pepechorva/Rabosa/Images/Rabosa_pcb.png

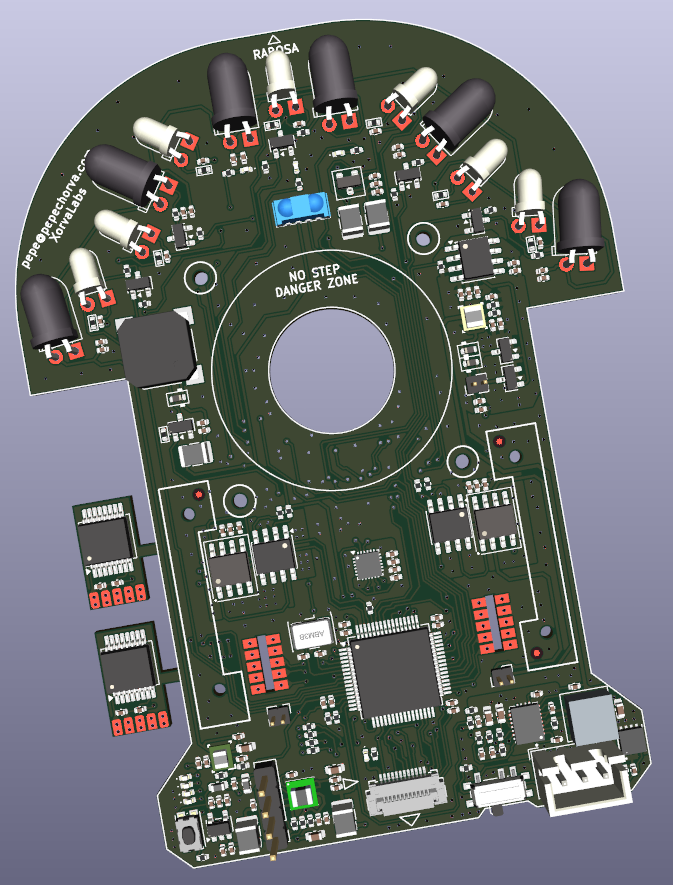
Images/Rabosa_pcb.png
