pepechorva/Rabosa/Hardware/KiCAD/Rabosa/IR_receiver.kicad_sch

## KiCad design Hardware/KiCAD/Rabosa/IR_receiver.kicad_sch (2025-11-17, last stored version)

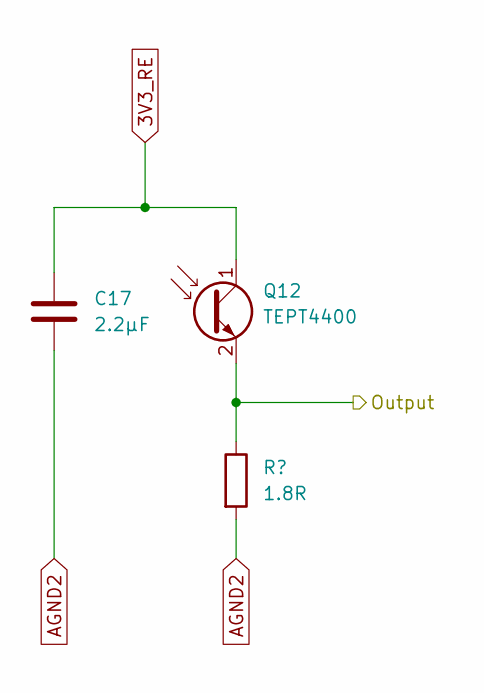
[picture p2: schematic IR_receiver.kicad_sch]

Parts:
C17: 2.2µF; C_0201_0603Metric
Q12: TEPT4400; LED_D3.0mm_Clear

Connections:
3V3_RE: C17.1, Q12.1 (C)
AGND2: C17.2
Output: Q12.2 (E)
