pepechorva/Rabosa/Hardware/KiCAD/Rabosa/Rabosa.kicad_sch

## KiCad design Hardware/KiCAD/Rabosa/Rabosa.kicad_sch (2025-11-17, last stored version)

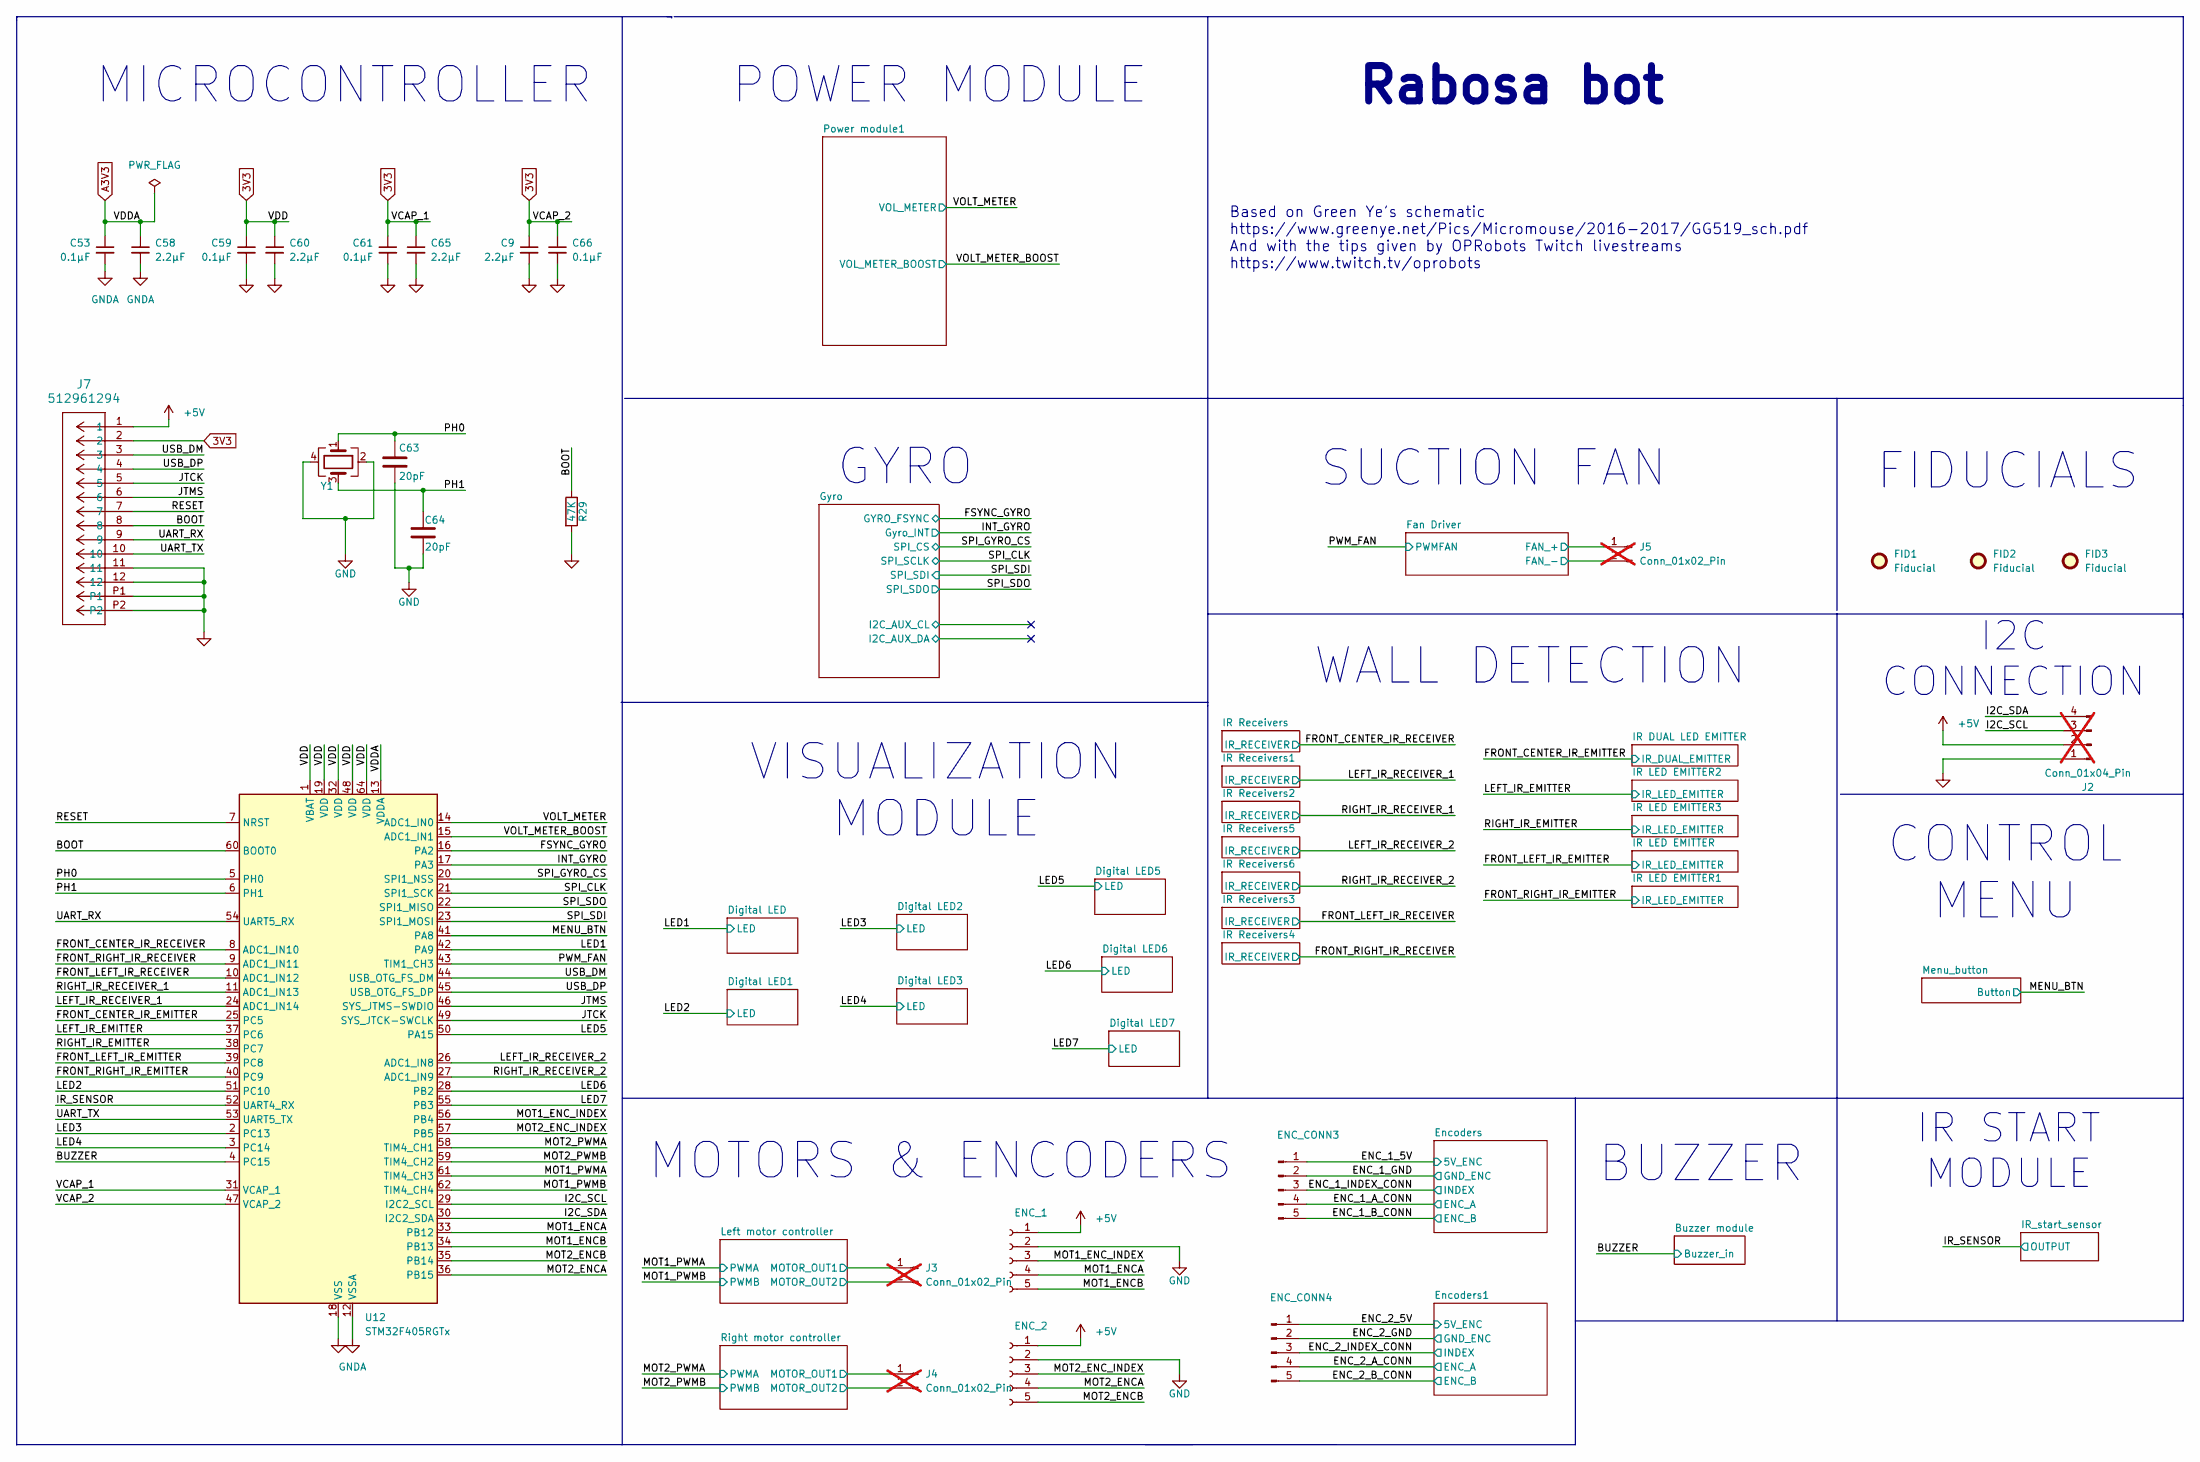
[picture p3: schematic Rabosa.kicad_sch]

Parts:
C9, C58, C60, C65: 2.2µF; C_0402_1005Metric; JLCPCB Part # C12530
C53, C59, C61, C66: 0.1µF; C_0402_1005Metric; JLCPCB Part # C1525
C63, C64: 20pF; C_0402_1005Metric; JLCPCB Part # C1554
ENC_1, ENC_2: Conn_01x05_Socket; Encoder_pcb; JLCPCB Part # NONE
ENC_CONN3, ENC_CONN4: Conn_01x05_Pin; encoder_conn; JLCPCB Part # NONE
FID1, FID2, FID3: Fiducial; Fiducial_0.75mm_Mask1.5mm; JLCPCB Part # NONE
J2: Conn_01x04_Pin; PinHeader_1x04_P2.54mm_Vertical; JLCPCB Part # C225256; not fitted
J3, J4, J5: Conn_01x02_Pin; PinHeader_1x02_P1.27mm_Vertical; JLCPCB Part # C131337; not fitted
J7: 512961294; CON_512961294_MOL; JLCPCB Part # C588127
R29: 47K; R_0402_1005Metric; JLCPCB Part # C25563
U12: STM32F405RGTx; LQFP-64_10x10mm_P0.5mm; JLCPCB Part # C94355
Y1: Crystal_GND24; Crystal_SMD_5032-4Pin_5.0x3.2mm; JLCPCB Part # C596873

Connections:
3V3: C9.1, C59.1, C60.1, C61.1, C65.1, C66.1, J7.2, U12.1 (VBAT), U12.19 (VDD), U12.31 (VCAP_1), U12.32 (VDD), U12.47 (VCAP_2), U12.48 (VDD), U12.64 (VDD)
+5V: ENC_1.1, ENC_2.1, J2.2, J7.1
A3V3: C53.1, C58.1, U12.13 (VDDA)
BOOT: J7.8, R29.1, U12.60 (BOOT0)
BUZZER: U12.4 (PC15)
ENC_1_5V: ENC_CONN3.1
ENC_1_A_CONN: ENC_CONN3.4
ENC_1_B_CONN: ENC_CONN3.5
ENC_1_GND: ENC_CONN3.2
ENC_1_INDEX_CONN: ENC_CONN3.3
ENC_2_5V: ENC_CONN4.1
ENC_2_A_CONN: ENC_CONN4.4
ENC_2_B_CONN: ENC_CONN4.5
ENC_2_GND: ENC_CONN4.2
ENC_2_INDEX_CONN: ENC_CONN4.3
FAN_+: J5.1
FAN_-: J5.2
FRONT_CENTER_IR_EMITTER: U12.25 (PC5)
FRONT_CENTER_IR_RECEIVER: U12.8 (PC0)
FRONT_LEFT_IR_EMITTER: U12.39 (PC8)
FRONT_LEFT_IR_RECEIVER: U12.10 (PC2)
FRONT_RIGHT_IR_EMITTER: U12.40 (PC9)
FRONT_RIGHT_IR_RECEIVER: U12.9 (PC1)
FSYNC_GYRO: U12.16 (PA2)
GND: C9.2, C59.2, C60.2, C61.2, C63.2, C64.2, C65.2, C66.2, ENC_1.2, ENC_2.2, J2.1, J7.11, J7.12, J7.P1, J7.P2, R29.2, U12.18 (VSS), U12.63 (VSS), Y1.2, Y1.4
GNDA: C53.2, C58.2, U12.12 (VSSA)
I2C_SCL: J2.3, U12.29 (PB10)
I2C_SDA: J2.4, U12.30 (PB11)
INT_GYRO: U12.17 (PA3)
IR_SENSOR: U12.52 (PC11)
JTCK: J7.5, U12.49 (PA14)
JTMS: J7.6, U12.46 (PA13)
LED1: U12.42 (PA9)
LED2: U12.51 (PC10)
LED3: U12.2 (PC13)
LED4: U12.3 (PC14)
LED5: U12.50 (PA15)
LED6: U12.28 (PB2)
LED7: U12.55 (PB3)
LEFT_IR_EMITTER: U12.37 (PC6)
LEFT_IR_RECEIVER_1: U12.24 (PC4)
LEFT_IR_RECEIVER_2: U12.26 (PB0)
MENU_BTN: U12.41 (PA8)
MOT1_ENCA: ENC_1.4, U12.33 (PB12)
MOT1_ENCB: ENC_1.5, U12.34 (PB13)
MOT1_ENC_INDEX: ENC_1.3, U12.56 (PB4)
MOT1_PWMA: U12.61 (PB8)
MOT1_PWMB: U12.62 (PB9)
MOT2_ENCA: ENC_2.4, U12.36 (PB15)
MOT2_ENCB: ENC_2.5, U12.35 (PB14)
MOT2_ENC_INDEX: ENC_2.3, U12.57 (PB5)
MOT2_PWMA: U12.58 (PB6)
MOT2_PWMB: U12.59 (PB7)
MOTOR_OUT1: J3.1, J4.1
MOTOR_OUT2: J3.2, J4.2
PH0: C63.1, U12.5 (PH0), Y1.1
PH1: C64.1, U12.6 (PH1), Y1.3
PWM_FAN: U12.43 (PA10)
RESET: J7.7, U12.7 (NRST)
RIGHT_IR_EMITTER: U12.38 (PC7)
RIGHT_IR_RECEIVER_1: U12.11 (PC3)
RIGHT_IR_RECEIVER_2: U12.27 (PB1)
SPI_CLK: U12.21 (PA5)
SPI_GYRO_CS: U12.20 (PA4)
SPI_SDI: U12.23 (PA7)
SPI_SDO: U12.22 (PA6)
UART_RX: J7.9, U12.54 (PD2)
UART_TX: J7.10, U12.53 (PC12)
USB_DM: J7.3, U12.44 (PA11)
USB_DP: J7.4, U12.45 (PA12)
VOLT_METER: U12.14 (PA0)
VOLT_METER_BOOST: U12.15 (PA1)

Notes on the sheet:
Rabosa bot
MICROCONTROLLER
GYRO
IR START MODULE
CONTROL MENU
FIDUCIALS
MOTORS & ENCODERS
WALL DETECTION
BUZZER
SUCTION FAN
POWER MODULE
Based on Green Ye's schematic https://www.greenye.net/Pics/Micromouse/2016-2017/GG519_sch.pdf And with the tips given by OPRobots Twitch livestreams https://www.twitch.tv/oprobots
I2C CONNECTION
VISUALIZATION MODULE
