pepechorva/Rabosa/Hardware/KiCAD/Rabosa/buzzer_module.kicad_sch

## KiCad design Hardware/KiCAD/Rabosa/buzzer_module.kicad_sch (2025-11-17, last stored version)

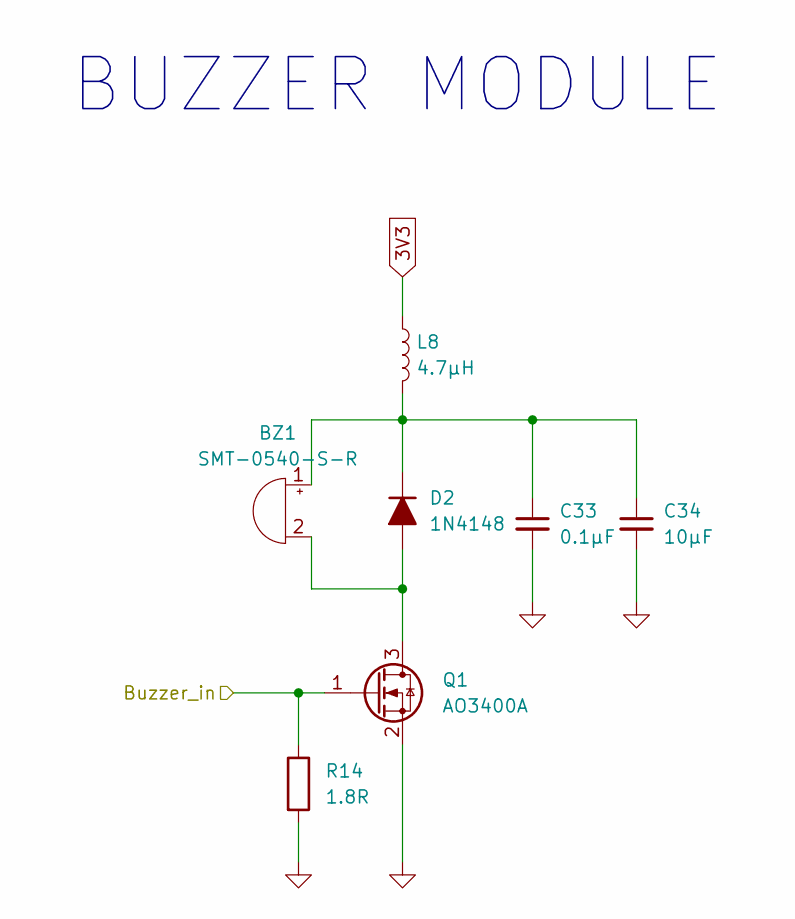
[picture p4: schematic buzzer_module.kicad_sch]

Parts:
BZ1: SMT-0540-S-R; MagneticBuzzer_Kobitone_254-EMB84Q-RO; JLCPCB Part # C3812104
C33: 0.1µF; C_0402_1005Metric; JLCPCB Part # C1525
C34: 10µF; C_0402_1005Metric; JLCPCB Part # C15525
D2: 1N4148; D_SOD-523; JLCPCB Part # C727112
L8: 4.7µH; L_1210_3225Metric; JLCPCB Part # C56767
Q1: AO3400A; SOT-23; JLCPCB Part # C20917
R14: 1.8R; R_0402_1005Metric; JLCPCB Part # C174229

Connections:
3V3: L8.1
Buzzer_in: Q1.1 (G), R14.1
GND: C33.2, C34.2, Q1.2 (S), R14.2
unnamed: BZ1.1 (+), C33.1, C34.1, D2.1 (K), L8.2
unnamed: BZ1.2 (-), D2.2 (A), Q1.3 (D)

Notes on the sheet:
BUZZER MODULE
