pepechorva/Rabosa/Hardware/KiCAD/Rabosa/digital_led.kicad_sch

## KiCad design Hardware/KiCAD/Rabosa/digital_led.kicad_sch (2025-11-17, last stored version)

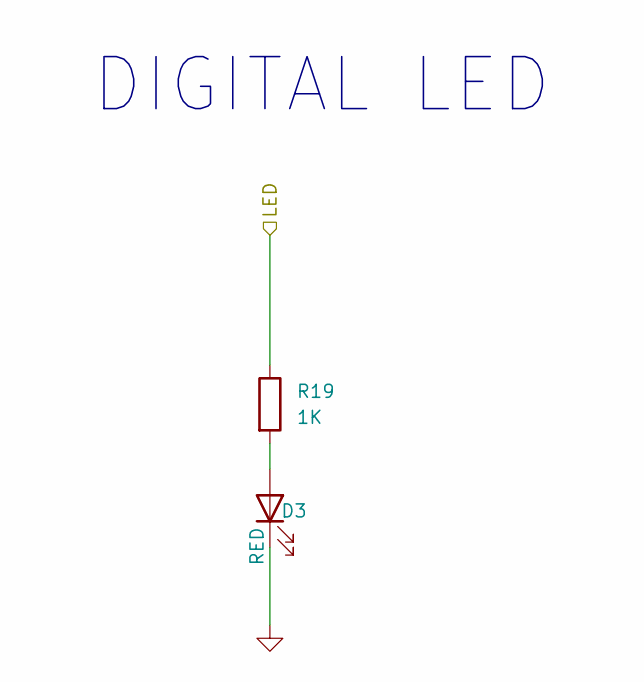
[picture p5: schematic digital_led.kicad_sch]

Parts:
D3: RED; LED_0402_1005Metric; JLCPCB Part # C71911
R19: 1K; R_0402_1005Metric; JLCPCB Part # C174151

Connections:
GND: D3.1 (K)
LED: R19.1
unnamed: D3.2 (A), R19.2

Notes on the sheet:
DIGITAL LED
