pepechorva/Rabosa/Hardware/KiCAD/Rabosa/double_IR_emitter.kicad_sch

## KiCad design Hardware/KiCAD/Rabosa/double_IR_emitter.kicad_sch (2025-11-17, last stored version)

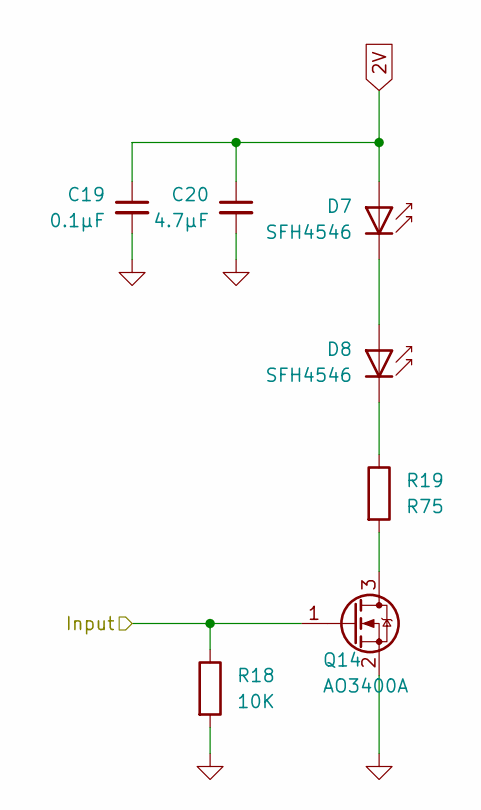
[picture p6: schematic double_IR_emitter.kicad_sch]

Parts:
C19: 0.1µF; C_0201_0603Metric
C20: 4.7µF; C_0201_0603Metric
D7, D8: SFH4546; LED_D5.0mm_IRGrey
Q14: AO3400A; SOT-23
R18: 10K; R_0201_0603Metric
R19: R75; R_0201_0603Metric

Connections:
2V: C19.1, C20.1, D7.2 (A)
GND: C19.2, C20.2, Q14.2 (S), R18.2
Input: Q14.1 (G), R18.1
unnamed: D7.1 (K), D8.2 (A)
unnamed: D8.1 (K), R19.1
unnamed: Q14.3 (D), R19.2
