pepechorva/Rabosa/Hardware/KiCAD/Rabosa/encoders.kicad_sch

## KiCad design Hardware/KiCAD/Rabosa/encoders.kicad_sch (2025-11-17, last stored version)

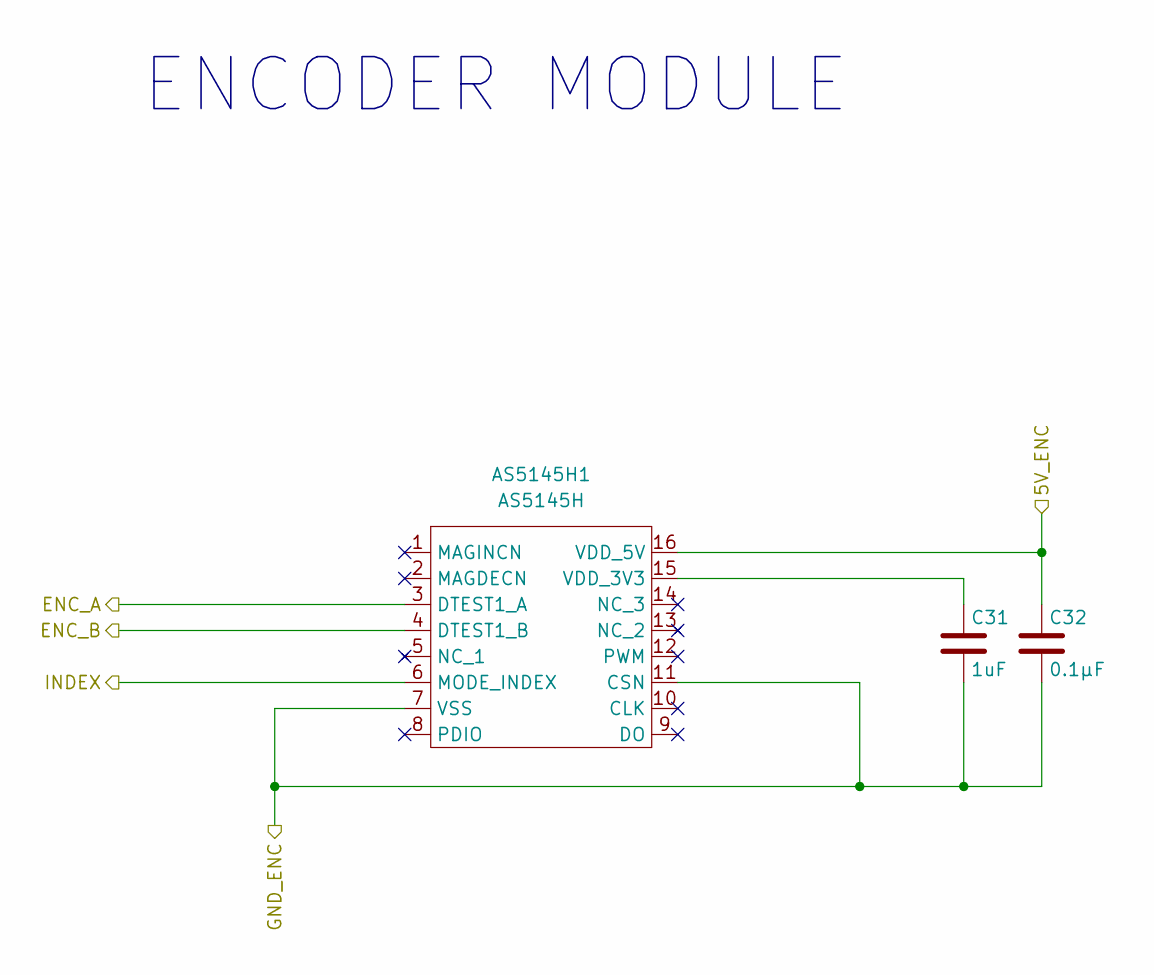
[picture p7: schematic encoders.kicad_sch]

Parts:
AS5145H1: AS5145H; SSOP-16_5.3x6.2mm_P0.65mm; JLCPCB Part # C481877
C31: 1uF; C_0402_1005Metric; JLCPCB Part # C14445
C32: 0.1µF; C_0402_1005Metric; JLCPCB Part # C1525

Connections:
5V_ENC: AS5145H1.16 (VDD_5V), C32.1
ENC_A: AS5145H1.3 (DTEST1_A)
ENC_B: AS5145H1.4 (DTEST1_B)
GND_ENC: AS5145H1.7 (VSS), AS5145H1.11 (CSN), C31.2, C32.2
INDEX: AS5145H1.6 (MODE_INDEX)
unnamed: AS5145H1.15 (VDD_3V3), C31.1

Notes on the sheet:
ENCODER MODULE
