pepechorva/Rabosa/Hardware/KiCAD/Rabosa/fan_driver.kicad_sch

## KiCad design Hardware/KiCAD/Rabosa/fan_driver.kicad_sch (2025-11-17, last stored version)

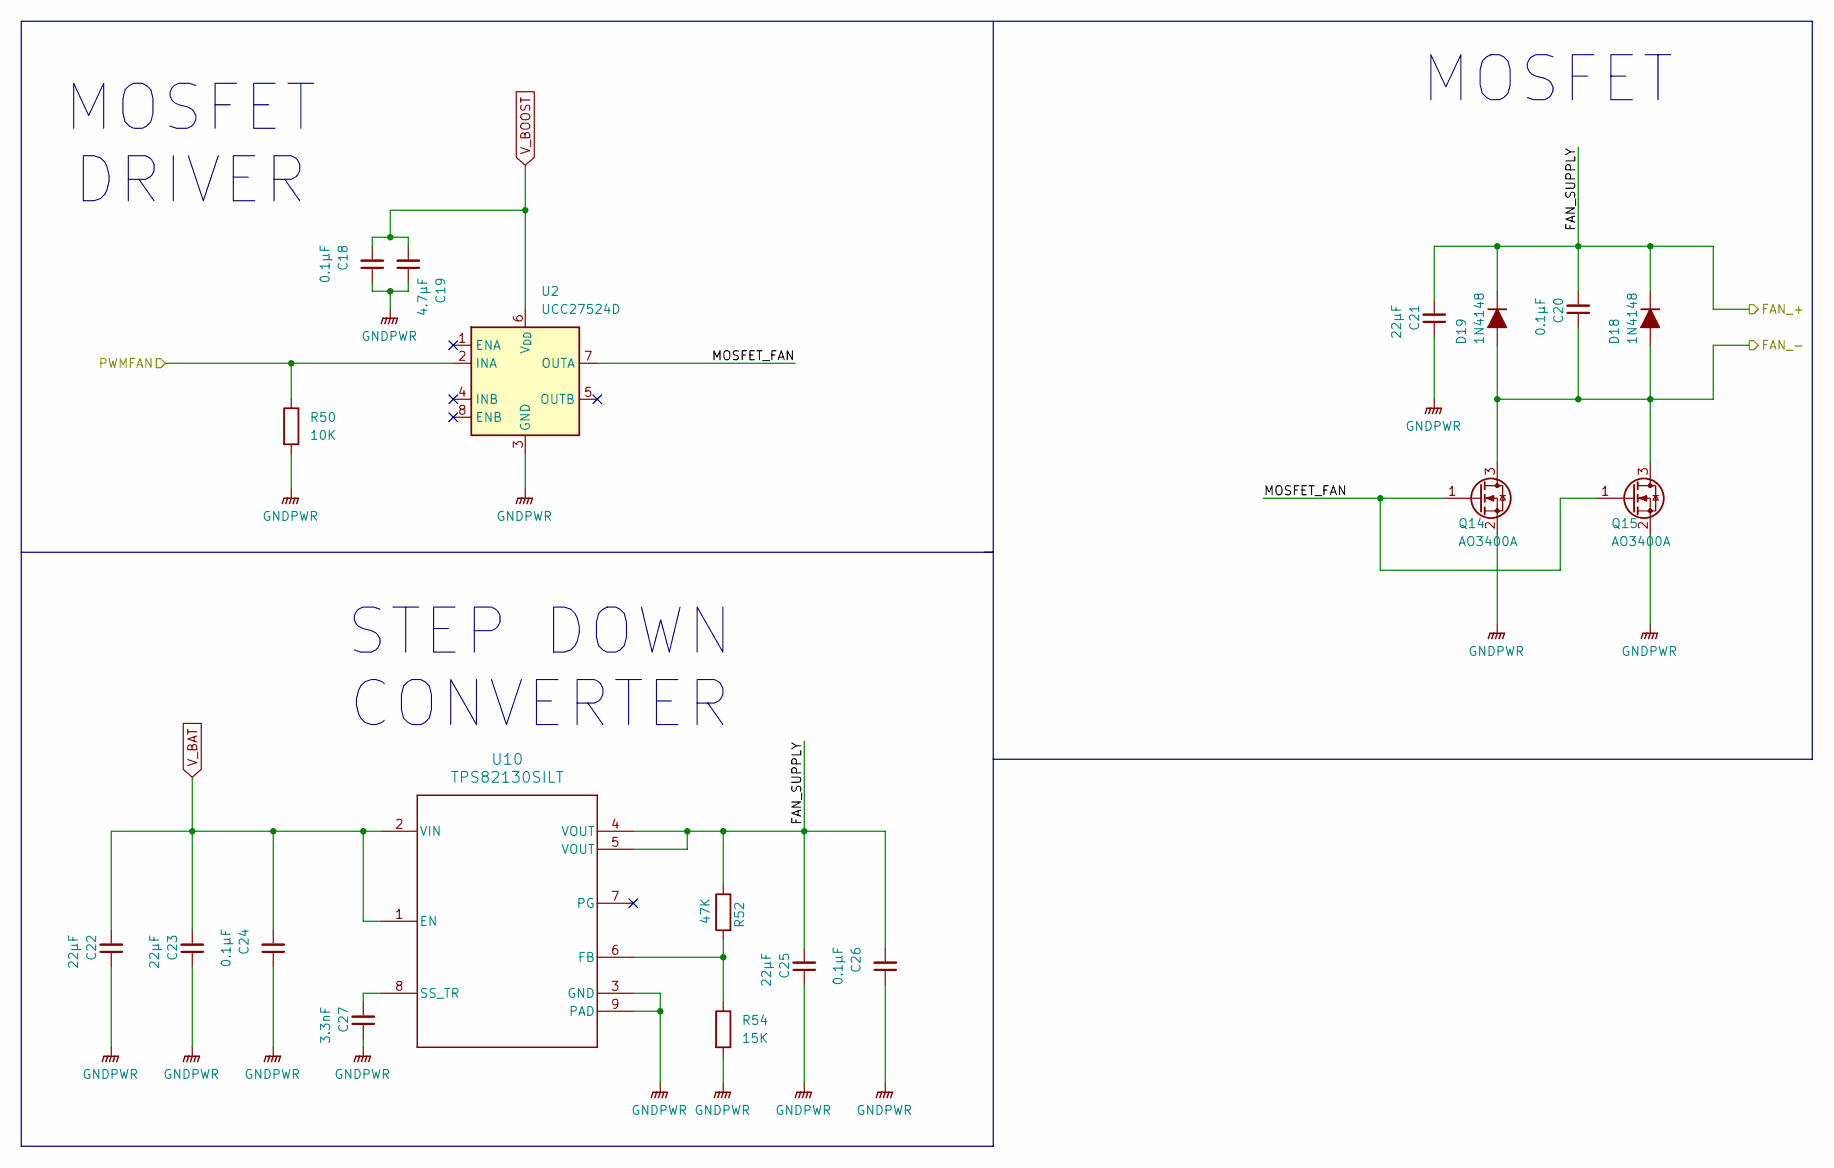
[picture p8: schematic fan_driver.kicad_sch]

Parts:
C18, C20, C24, C26: 0.1µF; C_0402_1005Metric; JLCPCB Part # C1525
C19: 4.7µF; C_0402_1005Metric; JLCPCB Part # C23687
C21, C22, C23, C25: 22µF; C_0402_1005Metric; JLCPCB Part # C105226
C27: 3.3nF; C_0402_1005Metric; JLCPCB Part # C1536
D18, D19: 1N4148; D_SOD-523; JLCPCB Part # C727112
Q14, Q15: AO3400A; SOT-23; JLCPCB Part # C20917
R50: 10K; R_0402_1005Metric; JLCPCB Part # C174175
R52: 47K; R_0402_1005Metric; JLCPCB Part # C25563
R54: 15K; R_0402_1005Metric; JLCPCB Part # C173692
U2: UCC27524D; SOIC-8_3.9x4.9mm_P1.27mm; JLCPCB Part # C5334499
U10: TPS82130SILT; JLCPCB Part # C163210

Connections:
FAN_+: C20.2, C21.2, C25.2, C26.2, D18.1 (K), D19.1 (K), R52.1, U10.4 (VOUT), U10.5 (VOUT)
FAN_-: C20.1, D18.2 (A), D19.2 (A), Q14.3 (D), Q15.3 (D)
GNDPWR: C18.1, C19.1, C21.1, C22.1, C23.1, C24.1, C25.1, C26.1, C27.1, Q14.2 (S), Q15.2 (S), R50.2, R54.2, U2.3 (GND), U10.3 (GND), U10.9 (PAD)
MOSFET_FAN: Q14.1 (G), Q15.1 (G), U2.7 (OUTA)
unnamed: C27.2, U10.8 (SS_TR)
unnamed: R52.2, R54.1, U10.6 (FB)
PWMFAN: R50.1, U2.2 (INA)
V_BAT: C22.2, C23.2, C24.2, U10.1 (EN), U10.2 (VIN)
V_BOOST: C18.2, C19.2, U2.6 (V_{DD})

Notes on the sheet:
MOSFET
STEP DOWN CONVERTER
MOSFET DRIVER
