pepechorva/Rabosa/Hardware/KiCAD/Rabosa/gyro.kicad_sch

## KiCad design Hardware/KiCAD/Rabosa/gyro.kicad_sch (2025-11-17, last stored version)

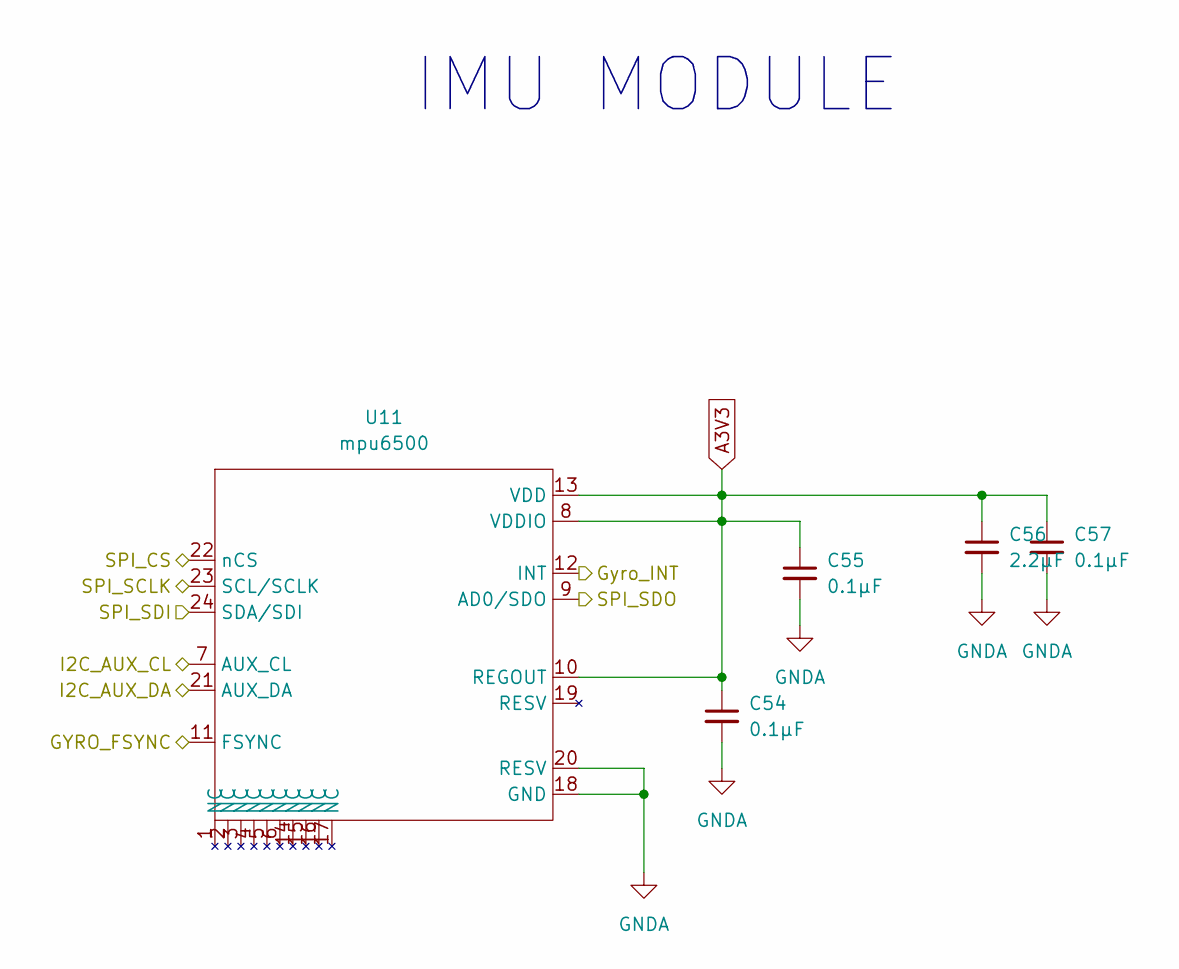
[picture p9: schematic gyro.kicad_sch]

Parts:
C54, C55, C57: 0.1µF; C_0402_1005Metric; JLCPCB Part # C1525
C56: 2.2µF; C_0402_1005Metric; JLCPCB Part # C12530
U11: mpu6500; InvenSense_QFN-24_3x3mm_P0.4mm; JLCPCB Part # C50278

Connections:
A3V3: C54.1, C55.1, C56.1, C57.1, U11.8 (VDDIO), U11.10 (REGOUT), U11.13 (VDD)
GNDA: C54.2, C55.2, C56.2, C57.2, U11.18 (GND), U11.20 (RESV)
GYRO_FSYNC: U11.11 (FSYNC)
Gyro_INT: U11.12 (INT)
I2C_AUX_CL: U11.7 (AUX_CL)
I2C_AUX_DA: U11.21 (AUX_DA)
SPI_CS: U11.22 (nCS)
SPI_SCLK: U11.23 (SCL/SCLK)
SPI_SDI: U11.24 (SDA/SDI)
SPI_SDO: U11.9 (AD0/SDO)

Notes on the sheet:
IMU MODULE
