pepechorva/Rabosa/Hardware/KiCAD/Rabosa/ir_dual_led_emitter.kicad_sch

## KiCad design Hardware/KiCAD/Rabosa/ir_dual_led_emitter.kicad_sch (2025-11-17, last stored version)

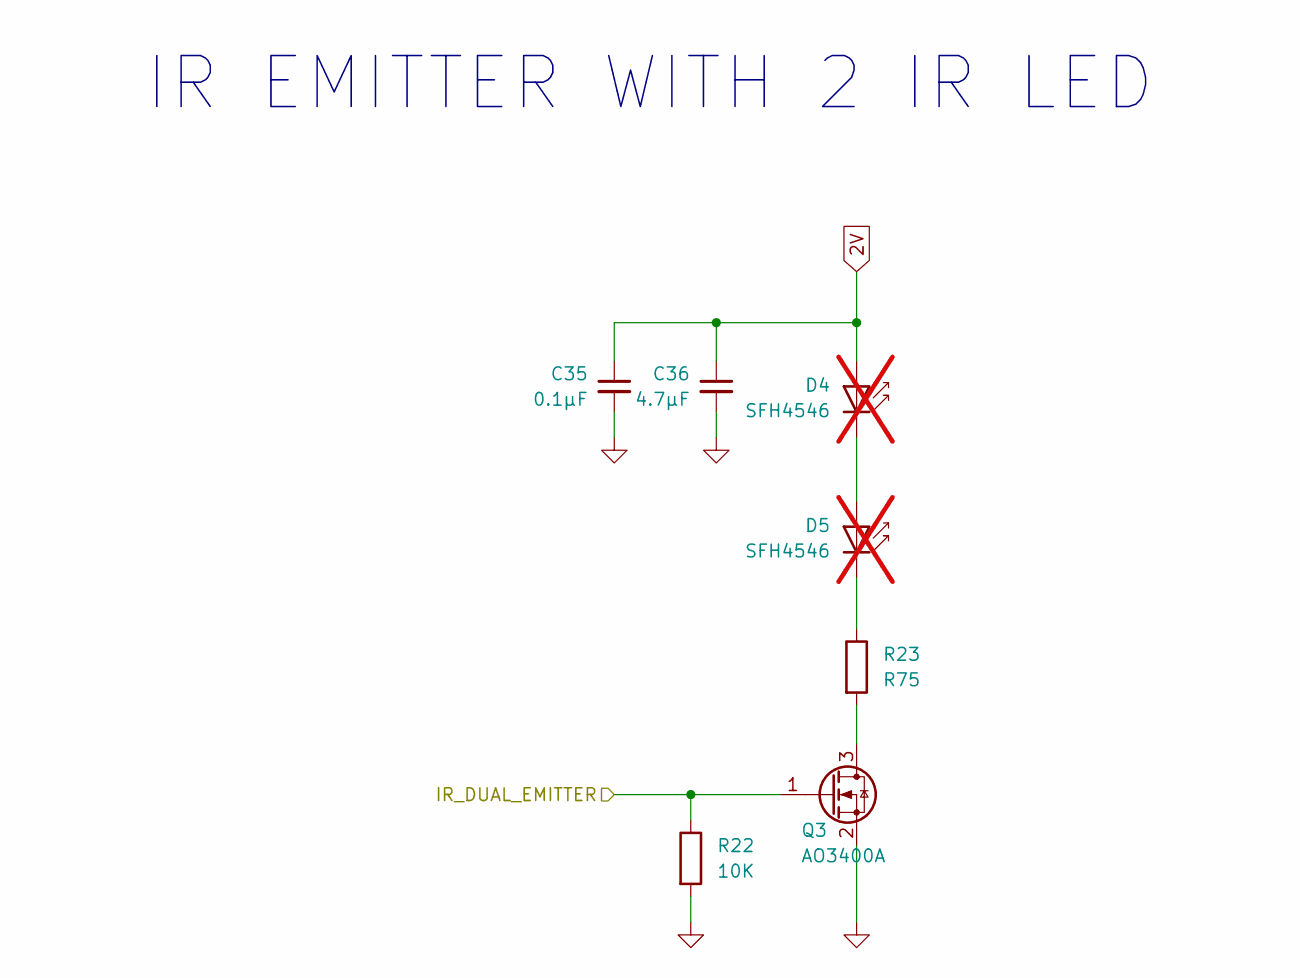
[picture p10: schematic ir_dual_led_emitter.kicad_sch]

Parts:
C35: 0.1µF; C_0402_1005Metric; JLCPCB Part # C1525
C36: 4.7µF; C_0402_1005Metric; JLCPCB Part # C23687
D4, D5: SFH4546; LED_D5.0mm_Horizontal_O1.27mm_Z3.0mm_IRGrey; JLCPCB Part # C2900373; not fitted
Q3: AO3400A; SOT-23; JLCPCB Part # C20917
R22: 10K; R_0402_1005Metric; JLCPCB Part # C174175
R23: R75; R_0402_1005Metric; JLCPCB Part # C22369159

Connections:
2V: C35.1, C36.1, D4.2 (A)
GND: C35.2, C36.2, Q3.2 (S), R22.2
IR_DUAL_EMITTER: Q3.1 (G), R22.1
unnamed: D4.1 (K), D5.2 (A)
unnamed: D5.1 (K), R23.1
unnamed: Q3.3 (D), R23.2

Notes on the sheet:
IR EMITTER WITH 2 IR LED
