pepechorva/Rabosa/Hardware/KiCAD/Rabosa/ir_emitter.kicad_sch

## KiCad design Hardware/KiCAD/Rabosa/ir_emitter.kicad_sch (2025-11-17, last stored version)

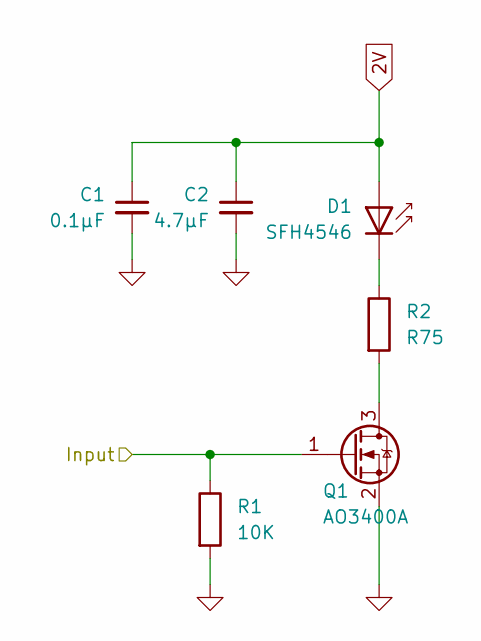
[picture p11: schematic ir_emitter.kicad_sch]

Parts:
C1: 0.1µF; C_0201_0603Metric
C2: 4.7µF; C_0201_0603Metric
D1: SFH4546; LED_D5.0mm_IRGrey
Q1: AO3400A; SOT-23
R1: 10K; R_0201_0603Metric
R2: R75; R_0201_0603Metric

Connections:
2V: C1.1, C2.1, D1.2 (A)
GND: C1.2, C2.2, Q1.2 (S), R1.2
Input: Q1.1 (G), R1.1
unnamed: D1.1 (K), R2.1
unnamed: Q1.3 (D), R2.2
