pepechorva/Rabosa/Hardware/KiCAD/Rabosa/ir_led_emitter.kicad_sch

## KiCad design Hardware/KiCAD/Rabosa/ir_led_emitter.kicad_sch (2025-11-17, last stored version)

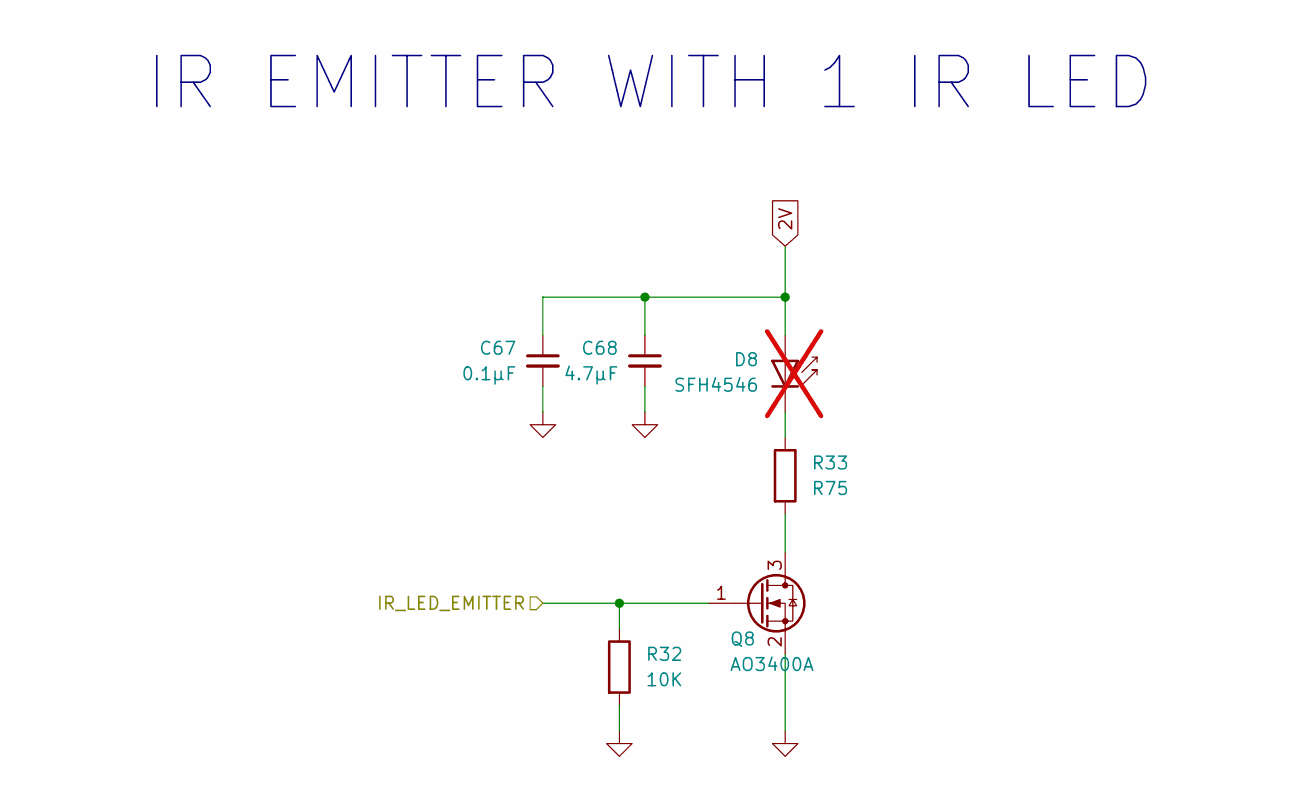
[picture p12: schematic ir_led_emitter.kicad_sch]

Parts:
C67: 0.1µF; C_0402_1005Metric; JLCPCB Part # C1525
C68: 4.7µF; C_0402_1005Metric; JLCPCB Part # C23687
D8: SFH4546; LED_D5.0mm_Horizontal_O1.27mm_Z3.0mm_IRGrey; JLCPCB Part # C2900373; not fitted
Q8: AO3400A; SOT-23; JLCPCB Part # C20917
R32: 10K; R_0402_1005Metric; JLCPCB Part # C174175
R33: R75; R_0402_1005Metric; JLCPCB Part # C22369159

Connections:
2V: C67.1, C68.1, D8.2 (A)
GND: C67.2, C68.2, Q8.2 (S), R32.2
IR_LED_EMITTER: Q8.1 (G), R32.1
unnamed: D8.1 (K), R33.1
unnamed: Q8.3 (D), R33.2

Notes on the sheet:
IR EMITTER WITH 1 IR LED
