pepechorva/Rabosa/Hardware/KiCAD/Rabosa/ir_receiver.kicad_sch

## KiCad design Hardware/KiCAD/Rabosa/ir_receiver.kicad_sch (2025-11-17, last stored version)

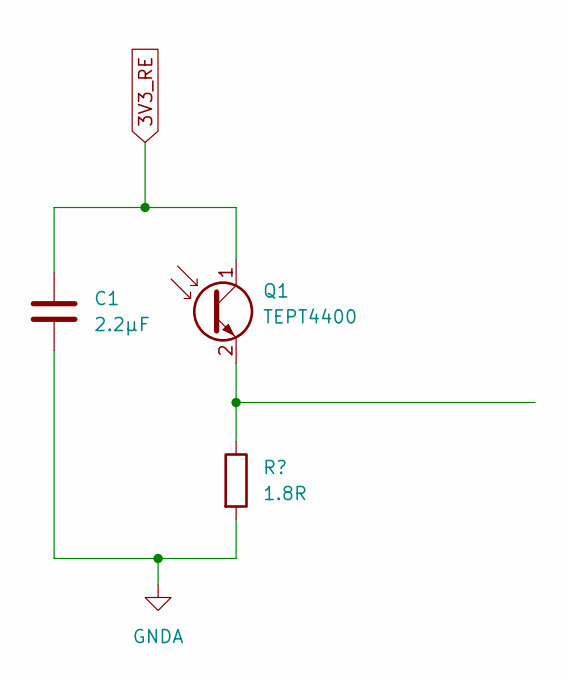
[picture p13: schematic ir_receiver.kicad_sch]

Parts:
C1: 2.2µF; C_0201_0603Metric
Q1: TEPT4400; LED_D3.0mm_Clear

Connections:
3V3_RE: C1.1, Q1.1 (C)
GNDA: C1.2
