pepechorva/Rabosa/Hardware/KiCAD/Rabosa/ir_receivers.kicad_sch

## KiCad design Hardware/KiCAD/Rabosa/ir_receivers.kicad_sch (2025-11-17, last stored version)

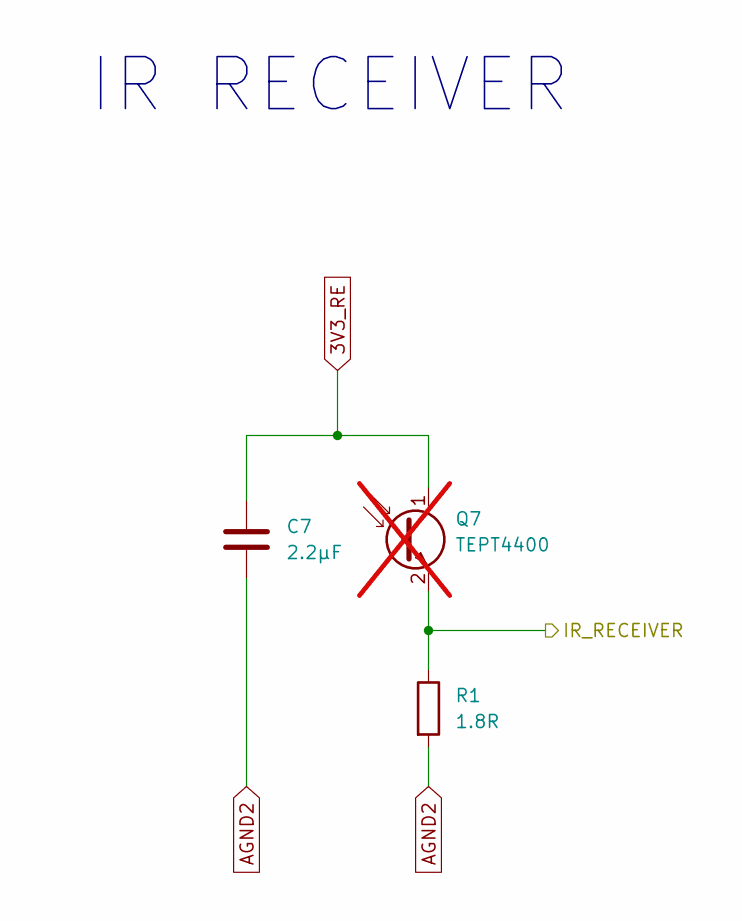
[picture p14: schematic ir_receivers.kicad_sch]

Parts:
C7: 2.2µF; C_0402_1005Metric; JLCPCB Part # C12530
Q7: TEPT4400; LED_D3.0mm_Horizontal_O1.27mm_Z2.0mm_Clear; JLCPCB Part # C132178; not fitted
R1: 1.8R; R_0402_1005Metric; JLCPCB Part # C174229

Connections:
3V3_RE: C7.1, Q7.1 (C)
AGND2: C7.2, R1.2
IR_RECEIVER: Q7.2 (E), R1.1

Notes on the sheet:
IR RECEIVER
