pepechorva/Rabosa/Hardware/KiCAD/Rabosa/microcontroller.kicad_sch

## KiCad design Hardware/KiCAD/Rabosa/microcontroller.kicad_sch (2025-11-17, last stored version)

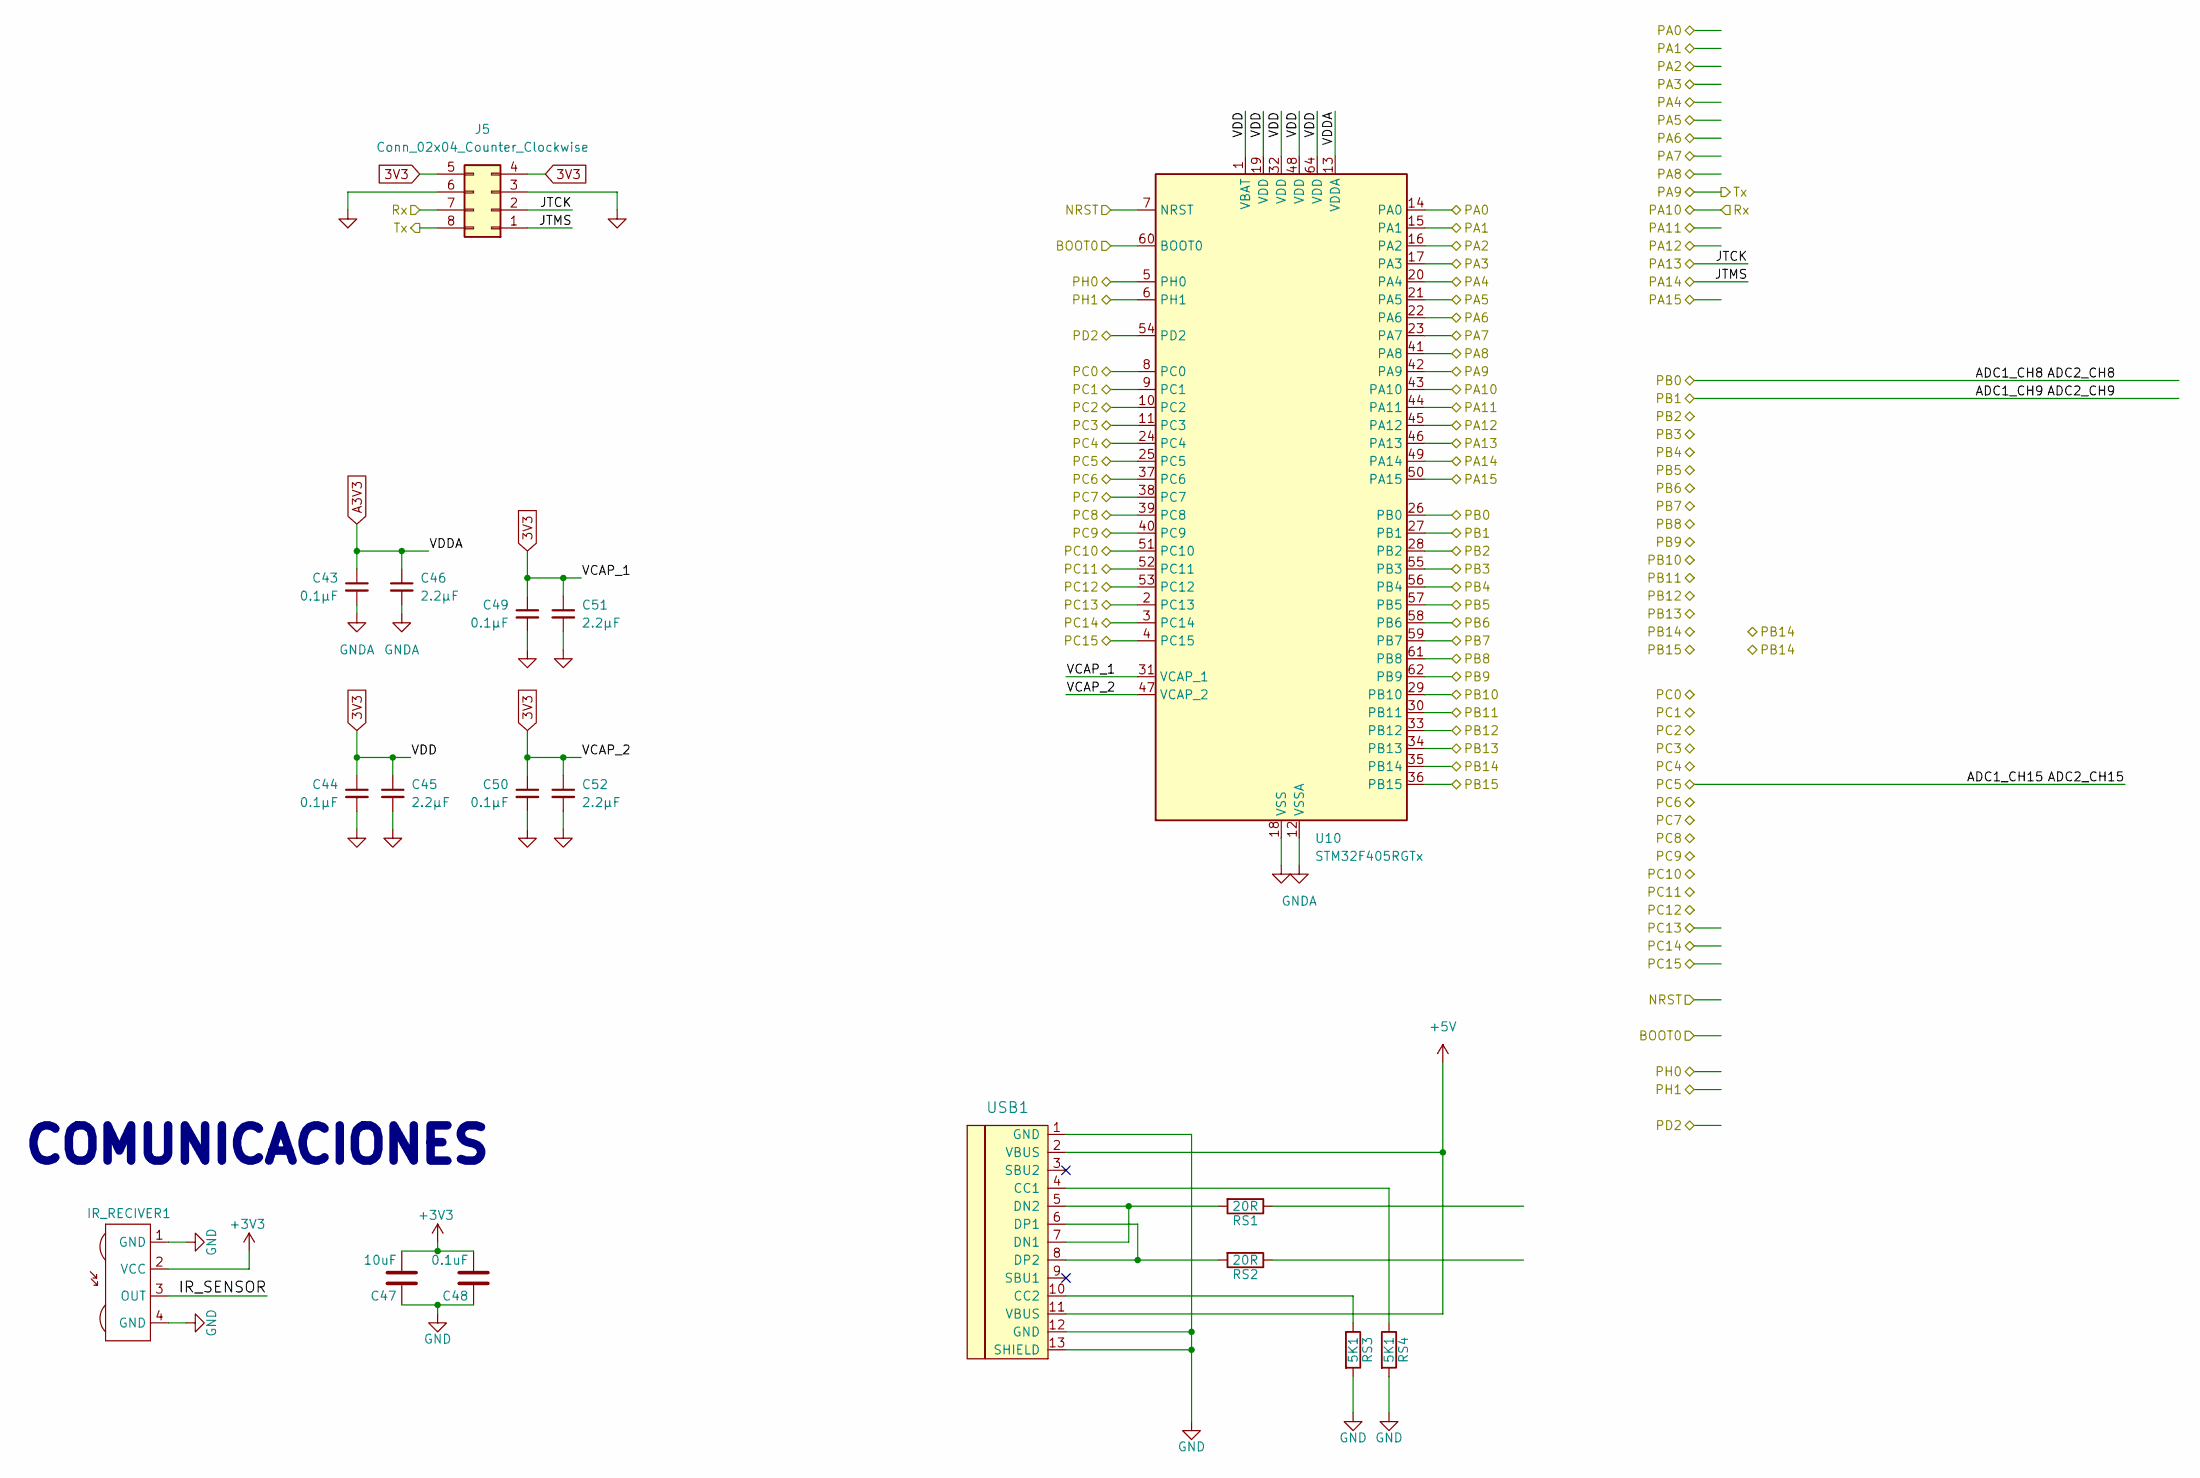
[picture p15: schematic microcontroller.kicad_sch]

Parts:
C43, C44, C49, C50: 0.1µF; C_0201_0603Metric
C45, C46, C51, C52: 2.2µF; C_0201_0603Metric
C47: 10uF; C_0402_1005Metric_Pad0.74x0.62mm_HandSolder
C48: 0.1uF; C_0402_1005Metric_Pad0.74x0.62mm_HandSolder
IR_RECIVER1: IR_SENSOR_SMD_TSSP77038ETR
J5: Conn_02x04_Counter_Clockwise; PinHeader_2x04_P2.54mm_Vertical
RS1, RS2: 20R; R_0805_2012Metric_Pad1.20x1.40mm_HandSolder
RS3, RS4: 5K1; R_0805_2012Metric_Pad1.20x1.40mm_HandSolder
U10: STM32F405RGTx; LQFP-64_10x10mm_P0.5mm
USB1: USB_C_Receptacle_GCT_USB4105-xx-A_16P_TopMnt_Horizontal

Connections:
3V3: C44.1, C45.1, C49.1, C50.1, C51.1, C52.1, J5.4, J5.5, U10.1 (VBAT), U10.19 (VDD), U10.31 (VCAP_1), U10.32 (VDD), U10.47 (VCAP_2), U10.48 (VDD), U10.64 (VDD)
+3V3: C47.2, C48.2, IR_RECIVER1.2 (VCC)
+5V: USB1.2 (VBUS), USB1.11 (VBUS)
A3V3: C43.1, C46.1, U10.13 (VDDA)
ADC1_CH8: U10.26 (PB0)
ADC1_CH9: U10.27 (PB1)
ADC1_CH15: U10.25 (PC5)
BOOT0: U10.60 (BOOT0)
GND: C44.2, C45.2, C47.1, C48.1, C49.2, C50.2, C51.2, C52.2, IR_RECIVER1.1 (GND), IR_RECIVER1.4 (GND), J5.3, J5.6, RS3.2, RS4.2, U10.18 (VSS), U10.63 (VSS), USB1.1 (GND), USB1.12 (GND), USB1.13 (SHIELD)
GNDA: C43.2, C46.2, U10.12 (VSSA)
IR_SENSOR: IR_RECIVER1.3 (OUT)
JTCK: J5.2, U10.46 (PA13)
JTMS: J5.1, U10.49 (PA14)
NRST: U10.7 (NRST)
unnamed: RS1.2, USB1.5 (DN2), USB1.7 (DN1)
unnamed: RS2.2, USB1.6 (DP1), USB1.8 (DP2)
unnamed: RS3.1, USB1.10 (CC2)
unnamed: RS4.1, USB1.4 (CC1)
PA0: U10.14 (PA0)
PA1: U10.15 (PA1)
PA2: U10.16 (PA2)
PA3: U10.17 (PA3)
PA4: U10.20 (PA4)
PA5: U10.21 (PA5)
PA6: U10.22 (PA6)
PA7: U10.23 (PA7)
PA8: U10.41 (PA8)
PA9: J5.8, U10.42 (PA9)
PA10: J5.7, U10.43 (PA10)
PA11: U10.44 (PA11)
PA12: U10.45 (PA12)
PA15: U10.50 (PA15)
PB2: U10.28 (PB2)
PB3: U10.55 (PB3)
PB4: U10.56 (PB4)
PB5: U10.57 (PB5)
PB6: U10.58 (PB6)
PB7: U10.59 (PB7)
PB8: U10.61 (PB8)
PB9: U10.62 (PB9)
PB10: U10.29 (PB10)
PB11: U10.30 (PB11)
PB12: U10.33 (PB12)
PB13: U10.34 (PB13)
PB14: U10.35 (PB14)
PB15: U10.36 (PB15)
PC0: U10.8 (PC0)
PC1: U10.9 (PC1)
PC2: U10.10 (PC2)
PC3: U10.11 (PC3)
PC4: U10.24 (PC4)
PC6: U10.37 (PC6)
PC7: U10.38 (PC7)
PC8: U10.39 (PC8)
PC9: U10.40 (PC9)
PC10: U10.51 (PC10)
PC11: U10.52 (PC11)
PC12: U10.53 (PC12)
PC13: U10.2 (PC13)
PC14: U10.3 (PC14)
PC15: U10.4 (PC15)
PD2: U10.54 (PD2)
PH0: U10.5 (PH0)
PH1: U10.6 (PH1)

Notes on the sheet:
COMUNICACIONES
