pepechorva/Rabosa/Hardware/KiCAD/Rabosa/motor_controller.kicad_sch

## KiCad design Hardware/KiCAD/Rabosa/motor_controller.kicad_sch (2025-11-17, last stored version)

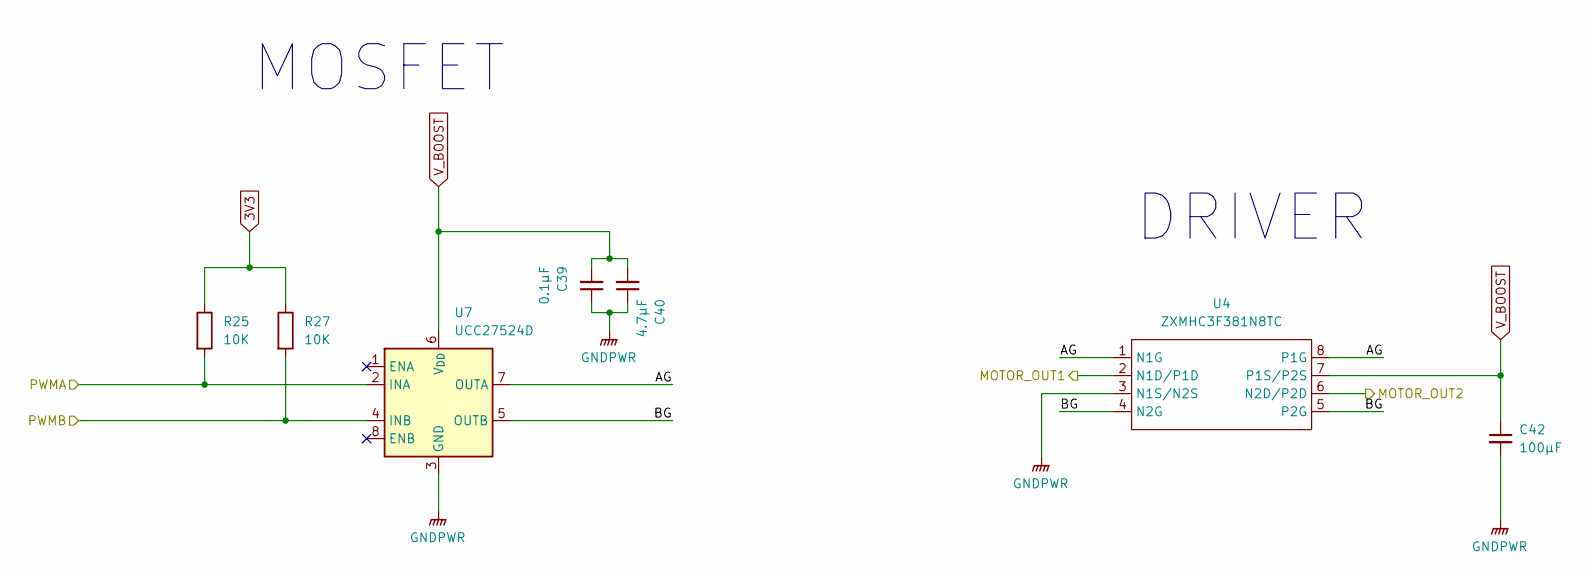
[picture p16: schematic motor_controller.kicad_sch]

Parts:
C39: 0.1µF; C_0402_1005Metric; JLCPCB Part # C1525
C40: 4.7µF; C_0402_1005Metric; JLCPCB Part # C23687
C42: 100µF; C_0402_1005Metric; JLCPCB Part # C1959836
R25, R27: 10K; R_0402_1005Metric; JLCPCB Part # C174175
U4: ZXMHC3F381N8TC; SOIC-8_3.9x4.9mm_P1.27mm; JLCPCB Part # C87356
U7: UCC27524D; SOIC-8_3.9x4.9mm_P1.27mm; JLCPCB Part # C5334499

Connections:
3V3: R25.1, R27.1
AG: U4.1 (N1G), U4.8 (P1G), U7.7 (OUTA)
BG: U4.4 (N2G), U4.5 (P2G), U7.5 (OUTB)
GNDPWR: C39.1, C40.1, C42.2, U4.3 (N1S/N2S), U7.3 (GND)
MOTOR_OUT1: U4.2 (N1D/P1D)
MOTOR_OUT2: U4.6 (N2D/P2D)
PWMA: R25.2, U7.2 (INA)
PWMB: R27.2, U7.4 (INB)
V_BOOST: C39.2, C40.2, C42.1, U4.7 (P1S/P2S), U7.6 (V_{DD})

Notes on the sheet:
MOSFET
DRIVER
