pepechorva/Rabosa/Hardware/KiCAD/Rabosa/plugable_led.kicad_sch

## KiCad design Hardware/KiCAD/Rabosa/plugable_led.kicad_sch (2025-11-17, last stored version)

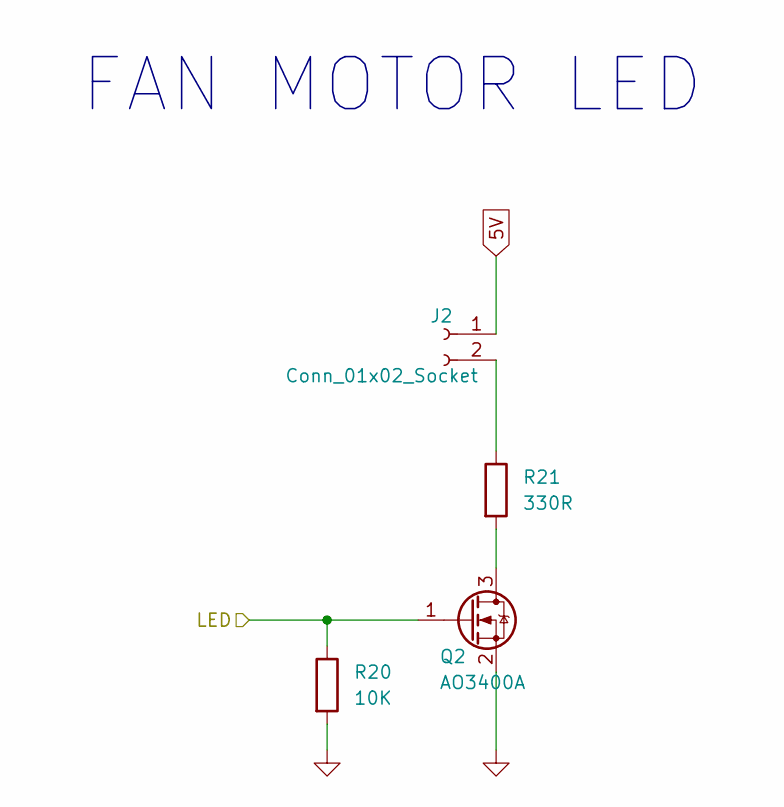
[picture p17: schematic plugable_led.kicad_sch]

Parts:
J2: Conn_01x02_Socket; PinSocket_1x02_P2.54mm_Vertical
Q2: AO3400A; SOT-23; JLCPCB Part # C20917
R20: 10K; R_0201_0603Metric; JLCPCB Part # C174175
R21: 330R; R_0201_0603Metric; JLCPCB Part # C177341

Connections:
5V: J2.1
GND: Q2.2 (S), R20.2
LED: Q2.1 (G), R20.1
unnamed: J2.2, R21.1
unnamed: Q2.3 (D), R21.2

Notes on the sheet:
FAN MOTOR LED
