pepechorva/Rabosa/Hardware/KiCAD/Rabosa/power_module.kicad_sch

## KiCad design Hardware/KiCAD/Rabosa/power_module.kicad_sch (2025-11-17, last stored version)

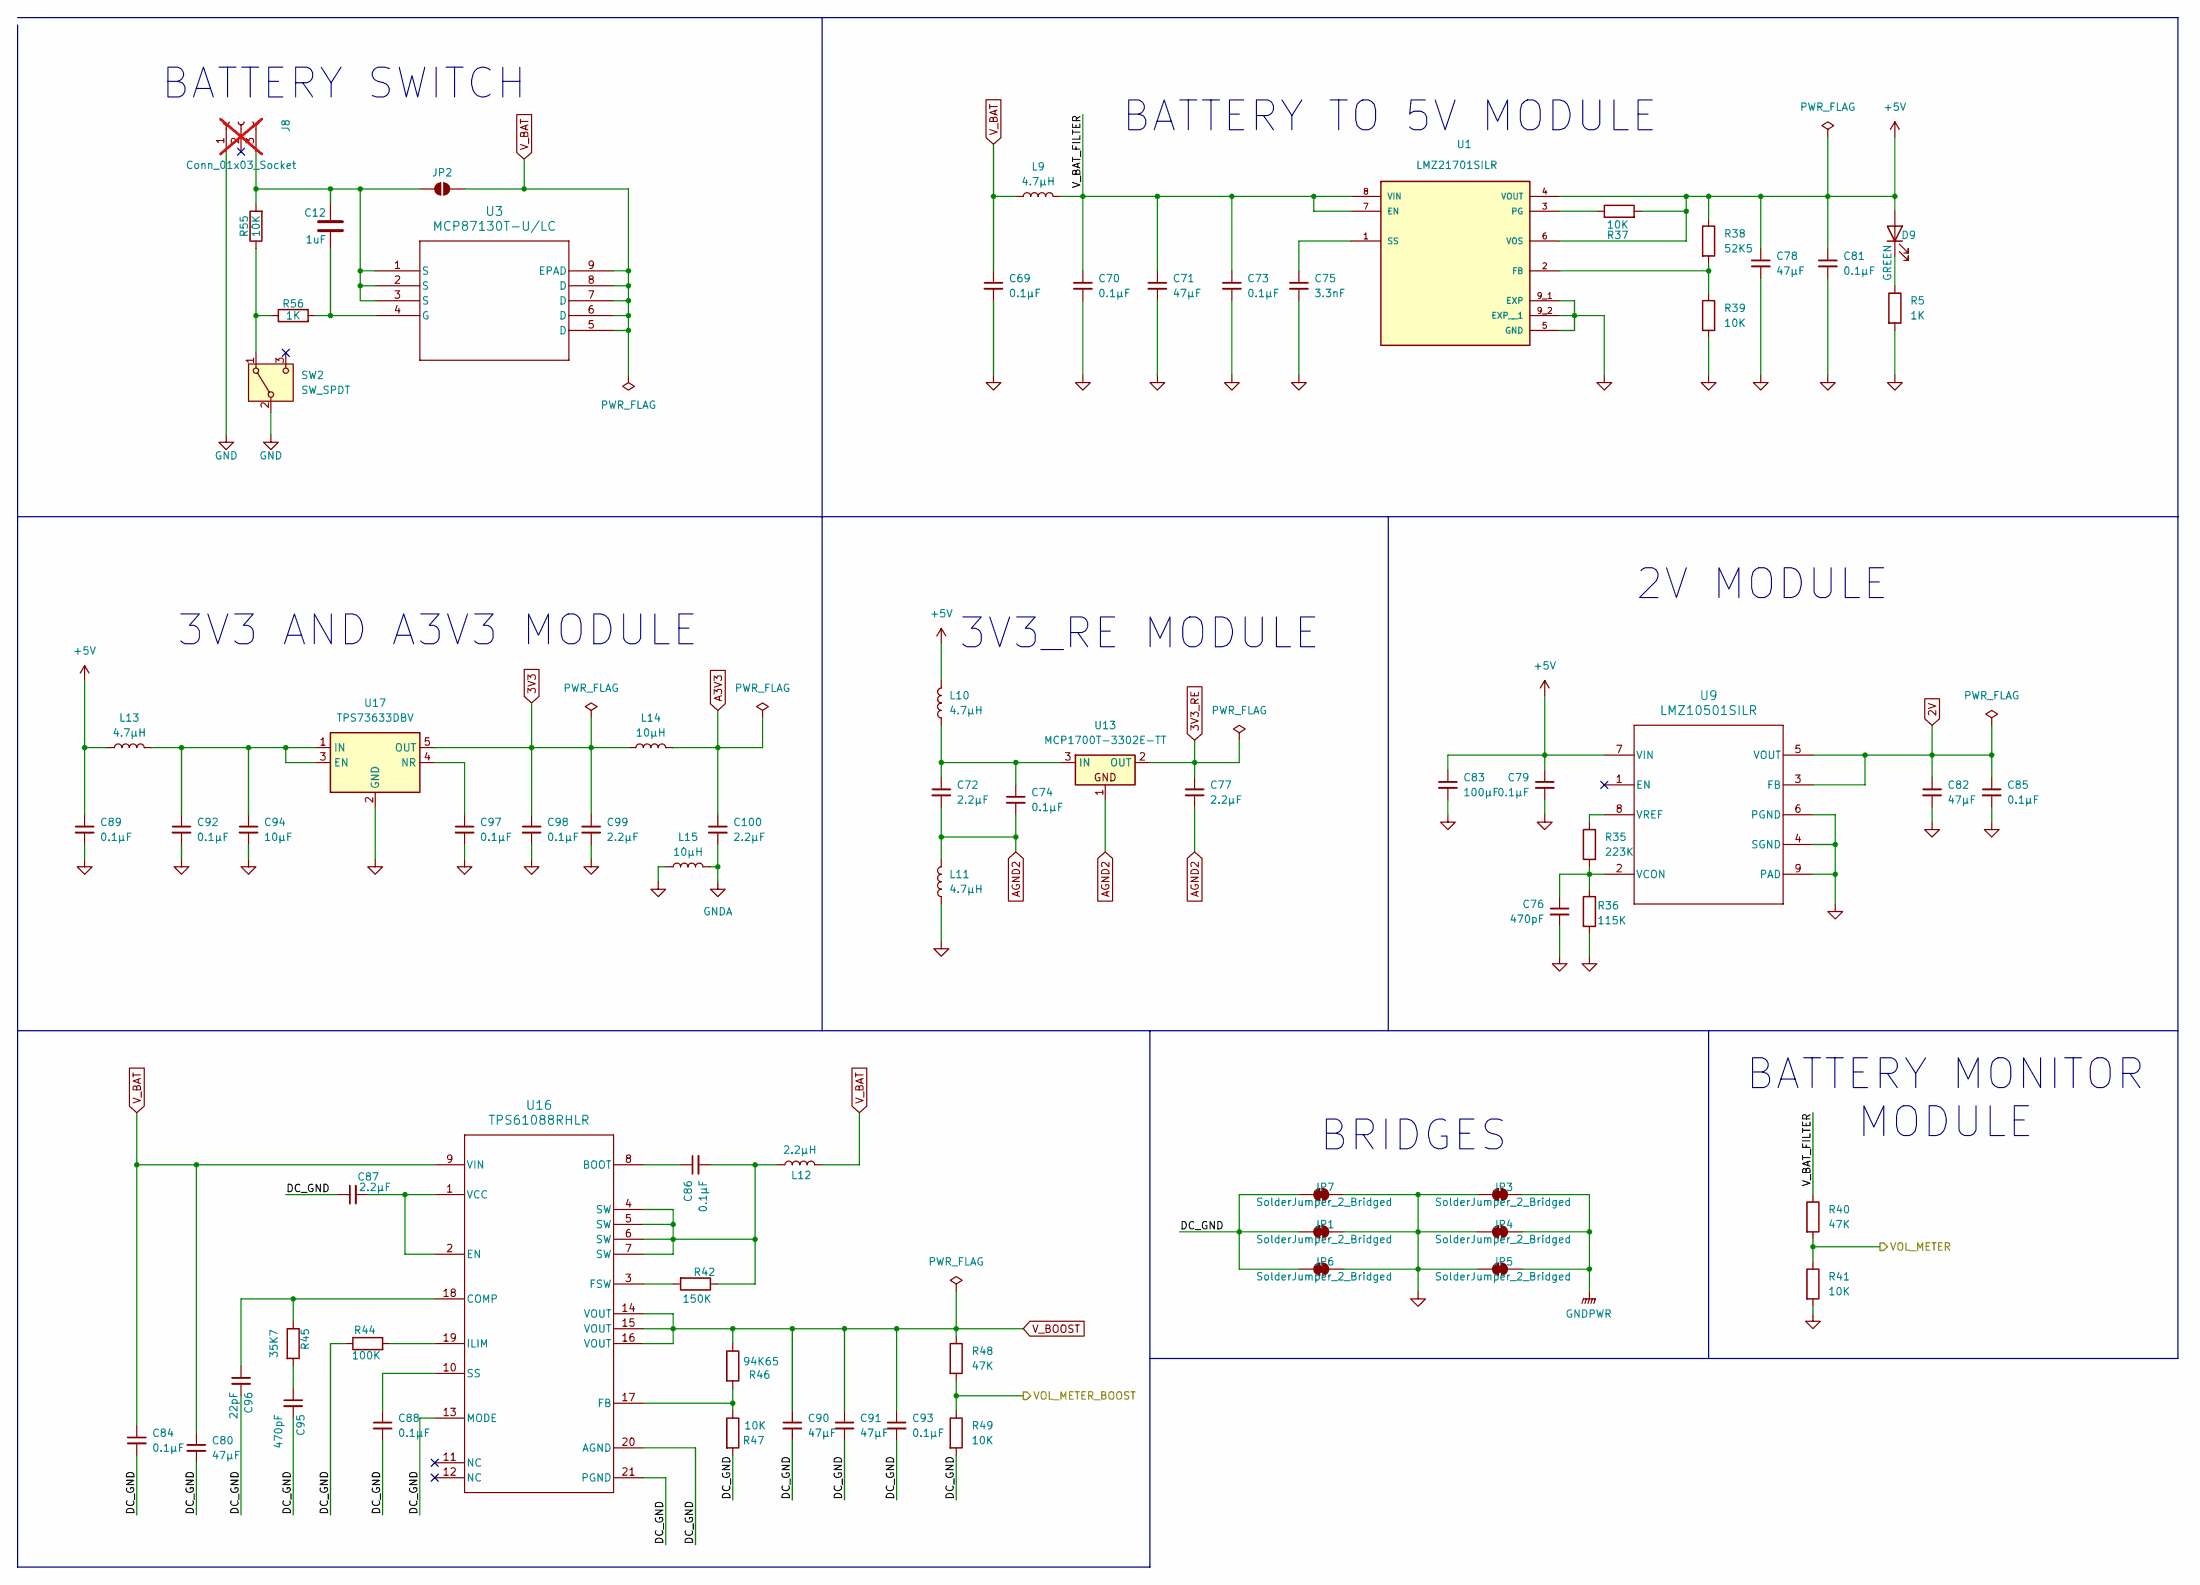
[picture p18: schematic power_module.kicad_sch]

Parts:
C12: 1uF; C_0402_1005Metric; JLCPCB Part # C14445
C69, C70, C73, C74, C79, C81, C84, C85, C86, C88, C89, C92, C93, C97, C98: 0.1µF; C_0402_1005Metric; JLCPCB Part # C1525
C71, C78, C80, C82, C90, C91: 47µF; C_0603_1608Metric; JLCPCB Part # C4980625
C72, C77, C87, C99, C100: 2.2µF; C_0402_1005Metric; JLCPCB Part # C12530
C75: 3.3nF; C_0402_1005Metric; JLCPCB Part # C1536
C76, C95: 470pF; C_0402_1005Metric; JLCPCB Part # C1537
C83: 100µF; C_0402_1005Metric; JLCPCB Part # C1959836
C94: 10µF; C_0402_1005Metric; JLCPCB Part # C15525
C96: 22pF; C_0402_1005Metric; JLCPCB Part # C1555
D9: GREEN; LED_0402_1005Metric; JLCPCB Part # C9900005854
J8: Conn_01x03_Socket; JST_XH_B3B-XH-A_1x03_P2.50mm_Vertical; JLCPCB Part # C131339; not fitted
JP1, JP3, JP4, JP5, JP6, JP7: SolderJumper_2_Bridged; SolderJumper-2_P1.3mm_Bridged2Bar_RoundedPad1.0x1.5mm; JLCPCB Part # NONE
JP2: SolderJumper_2_Open; SolderJumper-2_P1.3mm_Open_RoundedPad1.0x1.5mm; JLCPCB Part # NONE
L9, L10, L11, L13: 4.7µH; L_1210_3225Metric; JLCPCB Part # C56767
L12: 2.2µH; L_Coilcraft_XAL5030; JLCPCB Part # C920280
L14, L15: 10µH; L_0603_1608Metric; JLCPCB Part # C1035
R5, R56: 1K; R_0402_1005Metric; JLCPCB Part # C174151
R35: 223K; R_0402_1005Metric; JLCPCB Part # C25546
R36: 115K; R_0402_1005Metric; JLCPCB Part # C25747
R37, R39, R41, R47, R49, R55: 10K; R_0402_1005Metric; JLCPCB Part # C174175
R38: 52K5; R_0402_1005Metric; JLCPCB Part # C325555
R40, R48: 47K; R_0402_1005Metric; JLCPCB Part # C25563
R42: 150K; R_0402_1005Metric; JLCPCB Part # C1166
R44: 100K; R_0402_1005Metric; JLCPCB Part # C25530
R45: 35K7; R_0402_1005Metric; JLCPCB Part # C26975
R46: 94K65; R_0402_1005Metric; JLCPCB Part # C22375098
SW2: SW_SPDT; SW_SPDT_PCM12; JLCPCB Part # C136659
U1: LMZ21701SILR; CONV_LMZ21701SILR; PARTREV E; JLCPCB Part # C179688
U3: MCP87130T-U/LC; MCP87130T_U_LC; JLCPCB Part # C220835
U9: LMZ10501SILR; lmz10501; JLCPCB Part # C527412
U13: MCP1700T-3302E-TT; SOT-23; JLCPCB Part # C39051
U16: TPS61088RHLR; IC_TPS61088RHLR; JLCPCB Part # C87357
U17: TPS73633DBV; SOT-23-5; JLCPCB Part # C28038

Connections:
2V: C82.1, C85.1, U9.3 (FB), U9.5 (VOUT)
3V3: C98.1, C99.1, L14.1, U17.5 (OUT)
3V3_RE: C77.1, U13.2 (OUT)
+5V: C78.1, C79.1, C81.1, C83.1, C89.1, D9.2 (A), L10.2, L13.1, R37.2, R38.1, U1.4 (VOUT), U1.6 (VOS), U9.7 (VIN)
A3V3: C100.1, L14.2
AGND2: C72.2, C74.2, C77.2, L11.2, U13.1
DC_GND: C80.2, C84.2, C87.1, C88.2, C90.2, C91.2, C93.2, C95.2, C96.2, JP1.1 (A), JP6.1 (A), JP7.1 (A), R44.1, R47.2, R49.2, U16.13 (MODE), U16.20 (AGND), U16.21 (PGND)
GND: C69.2, C70.2, C71.2, C73.2, C75.2, C76.2, C78.2, C79.2, C81.2, C82.2, C83.2, C85.2, C89.2, C92.2, C94.2, C97.2, C98.2, C99.2, J8.1, JP1.2 (B), JP3.1 (A), JP4.1 (A), JP5.1 (A), JP6.2 (B), JP7.2 (B), L11.1, L15.1, R5.2, R36.2, R39.2, R41.2, SW2.2 (B), U1.5 (GND), U1.9_1 (EXP), U1.9_2 (EXP__1), U9.4 (SGND), U9.6 (PGND), U9.9 (PAD), U17.2 (GND)
GNDA: C100.2, L15.2
GNDPWR: JP3.2 (B), JP4.2 (B), JP5.2 (B)
unnamed: C12.1, J8.3, JP2.2 (B), R55.2, U3.1 (S), U3.2 (S), U3.3 (S)
unnamed: C12.2, R56.2, U3.4 (G)
unnamed: C72.1, C74.1, L10.1, U13.3 (IN)
unnamed: C75.1, U1.1 (SS)
unnamed: C76.1, R35.2, R36.1, U9.2 (VCON)
unnamed: C86.1, U16.8 (BOOT)
unnamed: C86.2, L12.2, R42.1, U16.4 (SW), U16.5 (SW), U16.6 (SW), U16.7 (SW)
unnamed: C87.2, U16.1 (VCC), U16.2 (EN)
unnamed: C88.1, U16.10 (SS)
unnamed: C92.1, C94.1, L13.2, U17.1 (IN), U17.3 (EN)
unnamed: C95.1, R45.2
unnamed: C96.1, R45.1, U16.18 (COMP)
unnamed: C97.1, U17.4 (NR)
unnamed: D9.1 (K), R5.1
unnamed: R35.1, U9.8 (VREF)
unnamed: R37.1, U1.3 (PG)
unnamed: R38.2, R39.1, U1.2 (FB)
unnamed: R42.2, U16.3 (FSW)
unnamed: R44.2, U16.19 (ILIM)
unnamed: R46.2, R47.1, U16.17 (FB)
unnamed: R55.1, R56.1, SW2.1 (A)
VOL_METER: R40.2, R41.1
VOL_METER_BOOST: R48.2, R49.1
V_BAT: C69.1, C80.1, C84.1, JP2.1 (A), L9.1, L12.1, U3.5 (D), U3.6 (D), U3.7 (D), U3.8 (D), U3.9 (EPAD), U16.9 (VIN)
V_BAT_FILTER: C70.1, C71.1, C73.1, L9.2, R40.1, U1.7 (EN), U1.8 (VIN)
V_BOOST: C90.1, C91.1, C93.1, R46.1, R48.1, U16.14 (VOUT), U16.15 (VOUT), U16.16 (VOUT)

Notes on the sheet:
3V3_RE MODULE
BATTERY SWITCH
BATTERY MONITOR MODULE
BRIDGES
3V3 AND A3V3 MODULE
2V MODULE
BATTERY TO 5V MODULE
