pepechorva/Rabosa/Hardware/KiCAD/Rabosa/pulldown_button.kicad_sch

## KiCad design Hardware/KiCAD/Rabosa/pulldown_button.kicad_sch (2025-11-17, last stored version)

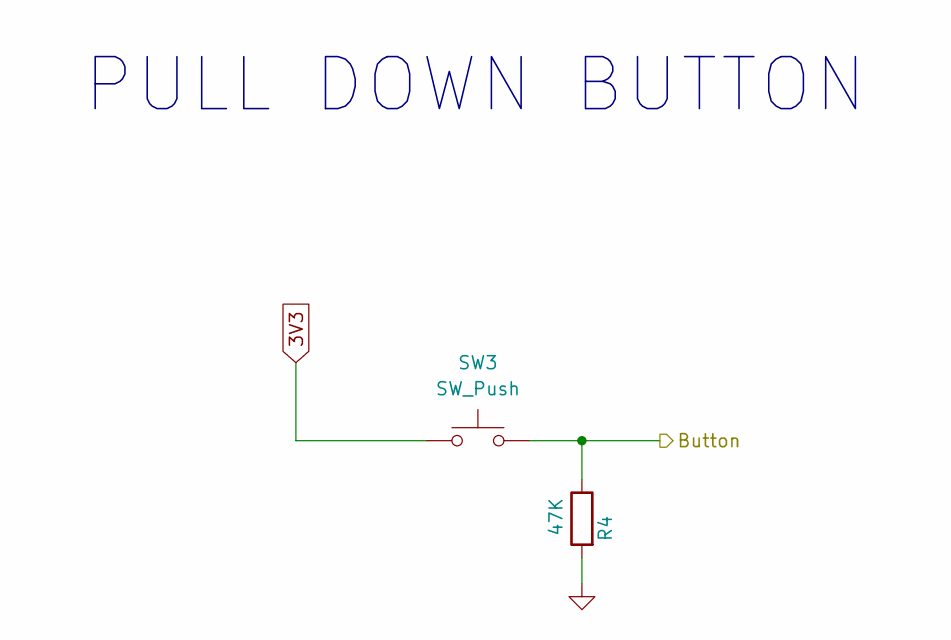
[picture p19: schematic pulldown_button.kicad_sch]

Parts:
R4: 47K; R_0402_1005Metric; JLCPCB Part # C25563
SW3: SW_Push; SW_Push_1P1T_NO_CK_KMR2; JLCPCB Part # C221676

Connections:
3V3: SW3.1
Button: R4.1, SW3.2
GND: R4.2

Notes on the sheet:
PULL DOWN BUTTON
