pepechorva/Rabosa/Hardware/KiCAD/Rabosa/pullup_button.kicad_sch

## KiCad design Hardware/KiCAD/Rabosa/pullup_button.kicad_sch (2025-11-17, last stored version)

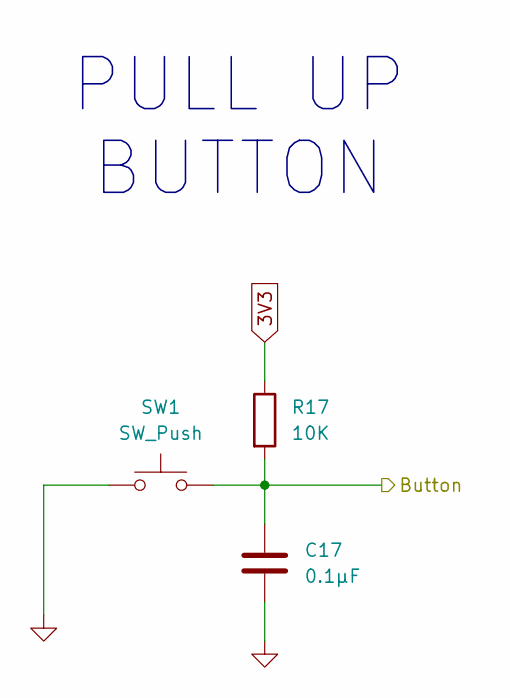
[picture p20: schematic pullup_button.kicad_sch]

Parts:
C17: 0.1µF; C_0201_0603Metric; JLCPCB Part # C1525
R17: 10K; R_0201_0603Metric; JLCPCB Part # C174175
SW1: SW_Push; SW_Push_1P1T_NO_CK_KMR2; JLCPCB Part # C221676

Connections:
3V3: R17.1
Button: C17.1, R17.2, SW1.2
GND: C17.2, SW1.1

Notes on the sheet:
PULL UP BUTTON
