pepechorva/Rabosa/Hardware/KiCAD/Rabosa/pwm_led.kicad_sch

## KiCad design Hardware/KiCAD/Rabosa/pwm_led.kicad_sch (2025-11-17, last stored version)

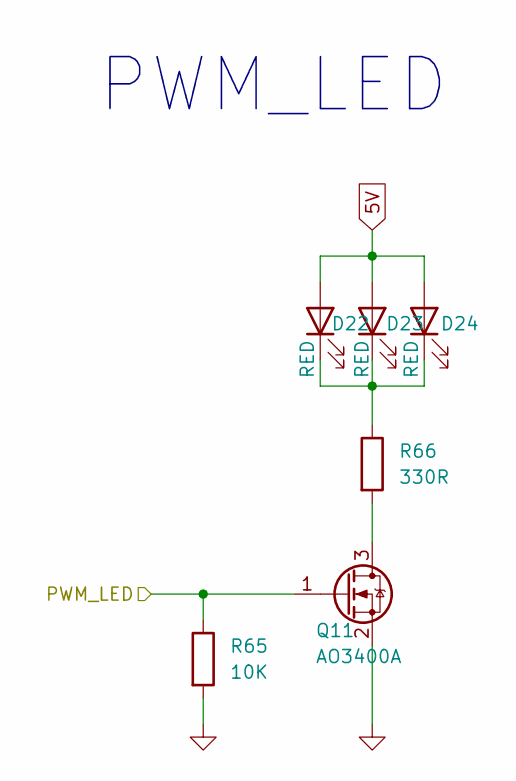
[picture p21: schematic pwm_led.kicad_sch]

Parts:
D22, D23, D24: RED; LED_0201_0603Metric; JLCPCB Part # C2286
Q11: AO3400A; SOT-23; JLCPCB Part # C20917
R65: 10K; R_0201_0603Metric; JLCPCB Part # C174175
R66: 330R; R_0201_0603Metric; JLCPCB Part # C177341

Connections:
5V: D22.2 (A), D23.2 (A), D24.2 (A)
GND: Q11.2 (S), R65.2
unnamed: D22.1 (K), D23.1 (K), D24.1 (K), R66.1
unnamed: Q11.3 (D), R66.2
PWM_LED: Q11.1 (G), R65.1

Notes on the sheet:
PWM_LED
