pepechorva/Rabosa/Hardware/KiCAD/Rabosa/usb_connector.kicad_sch

## KiCad design Hardware/KiCAD/Rabosa/usb_connector.kicad_sch (2025-11-17, last stored version)

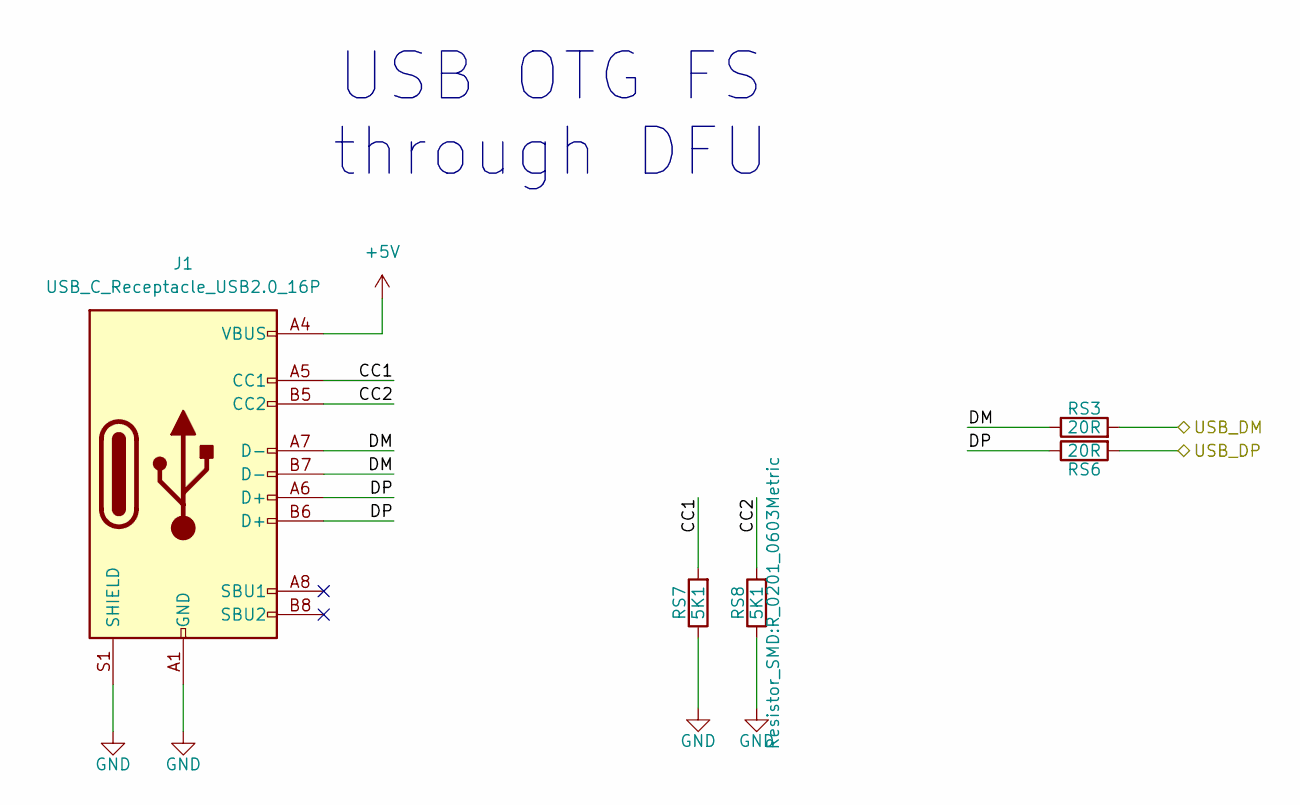
[picture p22: schematic usb_connector.kicad_sch]

Parts:
J1: USB_C_Receptacle_USB2.0_16P; USB_C_Receptacle_GCT_USB4110; JLCPCB Part # C5187472
RS3, RS6: 20R; R_0201_0603Metric; JLCPCB Part # C22369786
RS7, RS8: 5K1; R_0201_0603Metric; JLCPCB Part # C177348

Connections:
+5V: J1.A4 (VBUS), J1.A9 (VBUS), J1.B4 (VBUS), J1.B9 (VBUS)
CC1: J1.A5 (CC1), RS7.2
CC2: J1.B5 (CC2), RS8.2
DM: J1.A7 (D-), J1.B7 (D-), RS3.1
DP: J1.A6 (D+), J1.B6 (D+), RS6.1
GND: J1.A1 (GND), J1.A12 (GND), J1.B1 (GND), J1.B12 (GND), J1.S1 (SHIELD), RS7.1, RS8.1
USB_DM: RS3.2
USB_DP: RS6.2

Notes on the sheet:
USB OTG FS through DFU
