pepechorva/Rabosa/(commit log)

2025-11-17 Rabosa KiCAD project added, first schematic and PCB revision
    [IR_emitters.kicad_sch, IR_receiver.kicad_sch, IR_start_sensor.kicad_sch, Rabosa.kicad_sch, buzzer_module.kicad_sch, digital_led.kicad_sch, double_IR_emitter.kicad_sch, encoders.kicad_sch]
2025-11-17 Added pcb screenshot
2025-11-22 refactor: Hardware folder deleted for submodule migration
    [IR_emitters.kicad_sch, IR_receiver.kicad_sch, IR_start_sensor.kicad_sch, Rabosa.kicad_sch, buzzer_module.kicad_sch, digital_led.kicad_sch, double_IR_emitter.kicad_sch, encoders.kicad_sch]
